AdamSedla/CoreXY-3D-printer/README.md

# CoreXY 3D printer - TrianglePrinter
Graduation project for Johannes Kepler gymnasium, school year 2022/23. Full project including documentation will be in this repository.
