AdamSedla/CoreXY-3D-printer/Documentation/CZ_documentation.pdf

# GYMNÁZIUM JANA KEPLERA

### Parléˇrova 2/118, 169 00 Praha 6

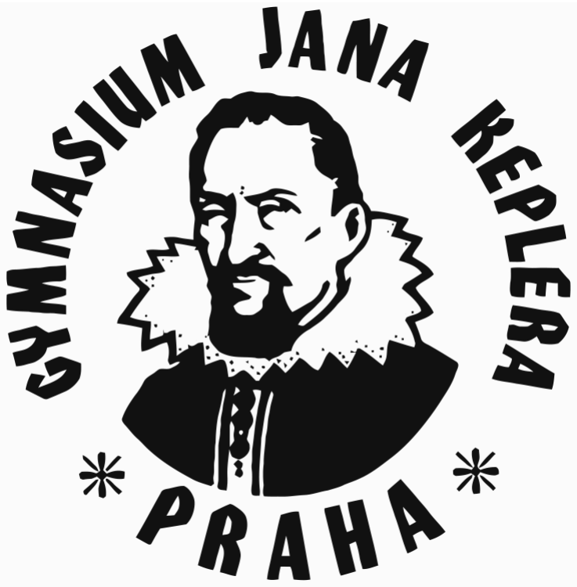
[picture p1: figure]

# Stavba CoreXY FDM 3D tiskárny

# Maturitní práce

### Autor: Adam Sedláˇcek

### Tˇrída: 4.C

### Školní rok: 2022/2023

### Pˇredmˇet: Informatika

### Vedoucí práce: Bc. Emil Miler

### Praha, 2023

# GYMNASIUM JANA KEPLERA Kabinet informatiky

# ZADÁNÍ MATURITNÍ PRÁCE

Student: | Adam Sedláˇcek
Tˇrída: | 4. C
Školní rok: | 2022/2023
Vedoucí práce: | Emil Miler
Název práce: | Stavba CoreXY FDM 3D tiskárny

## Pokyny pro vypracování:

Cílem práce je navrhnout a vytvoˇrit funkˇcní prototyp 3D FDM tiskárny urˇcené pro domácí sestavení z bˇežnˇe dostupných díl ˚u. Souˇcástí práce je pˇrehled dostupných technologií, návrh prototypu, díly k vytištˇení, seznam spojovacího materiálu, návod pro sestavení tiskárny a samotný prototyp.

## Doporuˇcená literatura:

[1] REDWOOD, Ben, Filemon SCHÖFFER a Brian GARRET. The 3D printing handbook: technologies, design and applications. Amsterdam: 3D Hubs, [2017]. ISBN 978-9082748505.

## URL repozitáˇre:

https://github.com/AdamSedla/FDM-3D-tiskarna

student | vedoucí práce

## V Praze dne 29. 9. 2022

# Prohlášení

Prohlašuji, že jsem svou práci vypracoval samostatnˇe a použil jsem pouze prameny a literaturu uvedené v seznamu bibliografických záznam ˚u. Nemám žádné námitky proti zpˇrístupˇnování této práce v souladu se zákonem ˇc. 121/2000 Sb. o právu autorském, o právech souvisejících s právem autorským a o zmˇenˇe nˇekterých zákon ˚u (autorský zákon) ve znˇení pozdˇejších pˇredpis ˚u.

V Praze dne 24. bˇrezna 2023 | Adam Sedláˇcek

# Podˇekování

Rád bych zde podˇekoval vedoucímu maturitní práce Bc. Emilu Milerovi za odborné vedení, cenné rady a ˇcas, který mi vˇenoval.

# Abstrakt

Práce se zabývá návrhem a sestavením funkˇcního prototypu FDM 3D tiskárny, urˇcené pro domácí sestavení z bˇežnˇe dostupných díl ˚u. Souˇcástí je pˇrehled dostupných technologií, návrh prototypu, seznam díl ˚u potˇrebných k úspˇešné stavbˇe tiskárny, vˇcetnˇe spojovacího materiálu, 3D modely díl ˚u k vytištˇení na 3D tiskárnˇe, návod pro sestavení tiskárny a prototyp samotný.

## Klíˇcová slova

3D tisk, FDM, XYZ, CoreXY

# Abstract

The thesis deals with the design and assembly of a functional prototype of a 3D FDM printer designed for home assembly from commonly available parts. It includes an overview of available technologies, a prototype design, a list of parts needed to successfully assemble the printer including fasteners, 3D models of the parts for printing on the 3D printer, instructions for assembling the printer and the prototype itself.

## Keywords

3D printer, FDM, XYZ, CoreXY

# Obsah

1 FDM 3D tiskárna | 2
2 Základní komponenty FDM 3D tiskárny | 5
3 návrhový proces tiskárny | 14
4 Stavba tiskárny | 23
5 Testování | 24
6 Možné vylepšení tiskárny | 25
7 Závˇer | 26
Závˇer | 26
Internetové zdroje | 27

# 1. FDM 3D tiskárna

V této ˇcásti se budu zabývat teorií FDM 3D tiskáren. Popíšu zde základy funkˇcnosti FDM 3D tiskárny a jejich typy. Pro terminologii používanou v následující ˇcásti je d ˚uležité ujasnit si osy. Osou Z je myšlena osa svislá. Osa X je ze strany na stranu. Osa Y je dopˇredu, dozadu.

# 1.1 Princip fungování

3D tiskárna na principu FDM (fused deposition modeling) Za pomocí jednotlivých souˇcástek extruderu (tiskové hlavy) vytlaˇcuje roztavený plast na pˇredem urˇcené místo na vyhˇrívané podložce. Plast je posouván podávacími koleˇcky, umístˇenými na krokovém motoru, který udává množství plastu, které je posouváno dále do extruderu. Plast je taven na samém konci tiskové hlavy v hotendu. Extrudovaný materiál je poté ochlazen pomocí pˇrídavného ventilátoru. V pˇrípadˇe Polar a XYZ principu je extruder a heatbed posouván po osách pomocí krokových motor ˚u, které jsou s posouvanou sou-ˇcástí tiskárny propojeny nejˇcastˇeji pomocí ˇremene nebo trapézové tyˇce. V pˇrípadˇe SCARA a Delta principu je pohybováno pouze extruderem a vyhˇrívaná podložka se nepohybuje. Teploty a pohyby souˇcástí jsou ˇrízeny pomocí základní desky. Ovládání funkcí základní desky je ˇrízeno pomocí pˇripojeného poˇcítaˇce nebo pomocí integrovaného displeje. Napájení elektrickou energií všech souˇcástí tiskárny je zaˇrízeno zdrojem elektrického napájení, ze kterého jde proud do základní desky, kde je požadovaná energie dodávána do jednotlivých souˇcástek.

# 1.2 Typy FDM 3D tiskáren

FDM 3D tiskárny lze rozdˇelit do 4 základních kategorií, dle principu pohybu tiskové hlavy, vzhledem ke vyhˇrívané podložce.

## 1.2.1 Cartesian

První a v souˇcasné dobˇe nejrozšíˇrenˇejší variantou je Cartesian. Jeho název je odvozen od Kartézské soustavy souˇradnic, kdy bod v prostoru je zapsán pomocí souˇradnic XYZ, které znázor ˇnují bod na osách, které jsou vzájemnˇe kolmé. Tyto tiskárny pohybují tiskovou hlavou a obdélníkovou vyhˇrívanou podložkou v osách, stejných jako jsou souˇradnice bodu v Kartézské soustavˇe. Tyto tiskárny se vyznaˇcují jednoduchostí, díky které jsou i relativnˇe levné. Tiskárna je vhodná nejen pro zaˇcáteˇcníky v 3D tisku, kteˇrí se na tomto zp ˚usobu mohou nauˇcit základy 3D tisku, ale také pro pokroˇcilé tiskaˇre, kteˇrí plnˇe využívají potenciálu tˇechto tiskáren. Také jsou pˇresné, ale oproti jiným druh ˚um 3D tiskáren nejsou tolik rychlé, vzhledem k nutnosti pohyb ˚u po osách. Kv ˚uli nutnosti pevného rámu jsou také pomˇernˇe tˇežké.

FDM 3D tiskárna

## CoreXY

CoreXY systém má hlavu pohybující se po osách X a Y. Tisková podložka je osou Z. Výhoda je vˇetší rychlost, vzhledem k lehkosti tiskové hlavy oproti podložce. Také zabírá ménˇe místa, protože nejrozmˇernˇejší souˇcást, kterou je tisková podložka, se pohybuje po ose Z. Nevýhodou je potˇreba komplexnˇejší konstrukce, která ale m ˚uže být zároveˇn i výhodou, protože nabízí vyšší pevnost rámu. Typicky je zde využita kombinace 2 motor ˚u pro pohyb po ose XY. Proto pˇri pohybu podél osy X/Y je potˇreba kooperace obou motor ˚u. Osu Z obstarává minimálnˇe jeden motor. Motory pro osu X a Y (tzv. motor A a B) m ˚uže být umístˇen na rámu. Nemusí se tedy pohybovat pˇri pohybu celou osou. To je další možnost vyšší rychlosti. Zamezení pohybu tisknutého objektu ze strany na stranu, jako je to nutné napˇríklad u CoreXZ, zvyšuje kvalitu tisku.

## H-bot

H-bot je svým principem prakticky identický s CoreXY. Jediným rozdílem je využití pouze jednoho ˇremenu pro pohon celé osy XY. Toto na jednu stranu m ˚uže zajistit mírnˇe jednodušší konstrukci. Nevýhody jsou ale menší pˇresnost a rychlost, vzhledem k nutnosti využití pouze jednoho ˇremenu.

## Crossed

Dalším principem, který je témˇeˇr identický s CoreXY je Crossed. Zde jsou pro osu X a Y využity 3 vedení na každou. Remen je veden okolo a nezasahuje do prostoru tisku. Výhodou je vyšší pˇresnost, ˇ nevýhodou vyšší váha a tím pádem i rychlost.

## CoreXZ

Zde se hlava pohybuje v ose X a Z. Tisková podložka je osou Y. Výhoda je zdánlivˇe menší prostorová nároˇcnost a menší nároky na komplexní rám. Také je zde lepší pˇrístup k tiskové hlavˇe v pˇrípadˇe servisu. Nevýhodou je potˇreba prostoru pro pohyb tiskové podložky, proto ve výsledku zabírá více prostoru. Pohybování tiskovou podložkou, která je pomˇernˇe tˇežká po ose Y, kde je vyžadován rychlejší pohyb, než na ose Z, ukazuje další nevýhodu tohoto systému. Podložku je totiž potˇreba rozpohybovat a také brzdit. Zde se projeví váha navíc, se kterou musíme hýbat. Každá osa zde m ˚uže mít vlastní motor. Na ose Z je použit typicky jeden nebo dva motory, záleží dle potˇreby. Využití separátních motor ˚u pro jednotlivé osy znamená, že kupˇríkladu motor pro osu X je potˇreba zvedat spoleˇcnˇe s celkem po ose Z. Toto je opˇet nechtˇená váha navíc. Vzhledem k pohybu tiskové plochy po relativnˇe dlouhých vzdálenostech, m ˚uže docházet ke zhoršení kvality tisknutého objektu, vzhledem k jeho otˇres ˚um.

## Belt

Osa Y je zde nekoneˇcnˇe dlouhá, díky využití pásu, na který je tisknuto typicky pod úhlem 45°. Tisková hlava se pohybuje po ose X a Z. Ve zkratce jde o CoreXZ, pouze s rozdílem pásové tiskové plochy a úhlem 45° mezi osou Z a Y.

FDM 3D tiskárna

## 1.2.2 Delta

FDM 3D tiskárny typu Delta lze také ˇradit pod Cartesian tiskárny, ale vzhledem k jejich rozdílnosti jsem se rozhodl je zaˇradit mimo. Tisková hlava je napojená na 3 spojovací tyˇce, které jsou spojeny každá s jedním posuvným bodem, který je posouván na svislých osách. Pˇri pohybu jedné osy se tisková hlava pohybuje smˇerem k posouvané ose, ale zároveˇn nahoru. Synchronizovaným pohybem všech 3 os docílíme schopnosti tisku v osách XYZ. Vyhˇrívaná podložka je kruhová a nepohyblivá Hlavní výhodou Delta tiskárny je její rychlost. Hlavní nevýhodou je prostorová nároˇcnost, vzhledem k nutnosti prostoru pro spojovací tyˇce nad nejvyšším bodem, kterého je tisková hlava dosáhnout. Tiskový prostor je omezen i co se týˇce podložky, kv ˚uli nutnosti kruhové vyhˇrívané podložky.

## 1.2.3 SCARA

Tiskárny SCARA (Selective Compliance Assembly Robot Arm) sice také používají Kartézskou soustavu souˇradnic, ale jsou opˇet natolik rozdílné, že je lze ˇradit do vlastní kategorie. Vyhˇrívaná podložka je zde opˇet kruhová a nejˇcastˇeji statická. Tisková hlava je umístˇena na jednom nebo dvou ramenech, každé má dva klouby. Ohybem tˇechto míst docílíme pohybu po celé oblasti os XY. Pohyb po ose Z m ˚uže být vykonáván bud’ pomocí pohybu celého ramena nebo pouze pomocí tiskové podložky. SCARA princip je bˇežnˇejší u robotických ramen, než u 3D tiskáren, proto se s ním nelze setkat pˇríliš ˇcasto, ve formˇe 3D tiskárny. Hlavní výhodou je rychlost, vzhledem k možnosti pohybu mimo kolmé osy. Druhou velkou výhodou je prostorová nenároˇcnost, díky které je to vhodný princip pro 3D tiskárny uzp ˚usobené pro velkoformátové tisky z industriálních materiál ˚u, jako je tˇreba beton. Tiskárna je tímto také jednoduchá na pˇrenos z jednoho místa na druhé. Hlavní nevýhodou je nepˇresnost tiskárny a nutnost vyvážení tiskového ramena, které je umístˇeno na kraji tiskové plochy.

## 1.2.4 Polar

Kategorie 3D tiskáren Polar jako jediný zp ˚usob ze seznamu nevyužívá Kartézskou soustavu sou-ˇradnic. Místo toho, jak už název napovídá, využívá Polarní zápis souˇradnic. Na rozdíl od Kartézské soustavy, je zde pro zápis umístˇení bodu v prostoru využit i úhel. Tisková hlava se zde pohybuje bud’ pouze svisle nebo se m ˚uže i naklápˇet, od stˇredu tiskové podložky po její kraj. Tisková podložka je zde kruhová a otoˇcná nebo i Pohyblivá, nahrazující pohyb tiskové hlavy od stˇredu ke kraji podložky. Hlavní výhodou je nízká cena a nenároˇcnost na konstrukci. Hlavní nevýhodou je nízká kvalita, rychlost tisku a z d ˚uvodu nerozšíˇrenosti tohoto zp ˚usobu i špatnˇe dostupná komunitní podpora.

# 2. Základní komponenty FDM 3D tiskárny

V této kapitole se budu vˇenovat všem základním komponent ˚um, ze kterých se FDM 3D tiskárna skládá.

# 2.1 Hardware

## 2.1.1 Rám

Nosný rám je možné sestavit témˇeˇr z ˇcehokoliv, co bude mít dostateˇcnou nosnost. Ale obecnˇe platí, že ˇcím pevnˇejší je rám, tím lépe bude poté tiskárna fungovat. Nejbˇežnˇeji používaným materiálem je hliník, konkrétnˇe profily z nˇej vyrobené, které mají v sobˇe zabudované drážky, do kterých je možné upevnit cokoliv, co má požadovaný tvar.

## 2.1.2 Vedení jednotlivých os pohybu

Vedení os pohybu je nosný díl os, který se skládá ze dvou ˇcástí, pevné a pohyblivé. Osa, se kterou je pohybováno je nejˇcastˇeji umístˇena na pohyblivé ˇcásti. Opaˇcné využití, kdy by se osa uchytila na ˇcást pevnou nemá žádné hlavní výhody.
U vˇetšiny FDM 3d tiskáren se m ˚užeme setkat s variantou jednoho ze tˇrí nejˇcastˇejších druh ˚u vedení. Prvním druhem je hlazená tyˇc, po které jezdí kluzné ložisko. Druhé je lineární pojezd s vozíkem. Hlazená tyˇc je nˇekolikanásobnˇe levnˇejší. Tím ale její výhody konˇcí. na druhou stranu je ménˇe pˇresná, z d ˚uvodu vˇetších v ˚uli. Také je mnohem více náchylná na špatnou údržbu. Pˇri vynechání pravidelného mazání hlazené tyˇce m ˚uže dojít k jejímu nenávratnému poškození vydˇrením drážek. Je také nároˇcnˇejší její uchycení, protože Lineární vedení má v sobˇe montážní body, díky kterým je jednoduché spojení s konstrukˇcním prvkem. U samotného vedení jde o otvory pro M3 šrouby, pomocí kterých je možné upevnˇení pˇrímo do 2020 profilu pouze pomocí odpovídajících kamen ˚u. Vozík lineárního vedení má integrované závity pro M3 šrouby. Oproti tomu hlazenou tyˇc a její ložisko je nutné upevnit pomocí dalšího konstrukˇcního prvku. Tˇretí variantou je vozík, jezdící po 2020 profilu, takzvaný V-slot. Výhodou je možnost pojezdu pˇrímo po 2020 profilu. To m ˚uže ušetˇrit mnoho místa. Nevýhodou je nutnost ˇcasté výmˇeny ložisek na vozíku. Pˇresnost m ˚uže být ze zaˇcátku podobná, jako u lineárního vedení, ale ˇcasem dochází k opotˇrebení ložisek a snížení pˇresnosti. Cenovˇe m ˚uže tento vozík pro 2020 profil vycházet velmi podobnˇe, jako lineární vedení.

## 2.1.3 Pohon jednotlivých os pohybu

FDM 3D tiskárna by nemohla fungovat bez pohybu tiskové podložky a tiskové hlavy. K zajištˇení pohybu je nutné nejenom vedení os, ale také jejich pohon. Respektive pˇrevedení otáˇcek motoru na skuteˇcný pohyb osy.
K tomu jsou využity 2 hlavní druhy pohonu, každý vhodný pro jiné využití. Pohon ˇremenem je

Základní komponenty FDM 3D tiskárny

vhodný nejˇcastˇeji pro osy X a Y, kde je potˇreba vyšší rychlost i za cenu nižší pˇresnosti. K jeho využití je nutné mít po ose umístˇené ˇremenice a vzhledem k jeho natahování pˇri dlouhodobém napnutí je vhodné mít zde umístˇenou napínací kladku nebo ˇremenici s variabilní pozicí, aby bylo dosaženo správného napnutí, protože pˇríliš povolený nebo napnutý ˇremen m ˚uže zp ˚usobovat vady tisku nebo poškození souˇcástek. Druhou variantou je trapézová tyˇc. Jde o závitovou tyˇc se závity ve tvaru rovnoramenného lichobˇežníku. Oproti ˇremenu jde o pˇresnˇejší, ale pomalejší zp ˚usob. Uchycení je jednodušší, protože zde není nutnost více konstrukˇcních prvk ˚u. Trapézová tyˇc m ˚uže držet pouze v motoru a její druhý konec je možné nechat volnˇe. Stejnˇe jako ˇremen je náchylný na špatné napnutí, trapézová tyˇc je náchylná na kˇrivost. Deformovaná tyˇc m ˚uže pˇri pˇríliš volném vedení osy, napˇríklad pˇri použití hlazené tyˇce zp ˚usobovat posun vrstvy a nedokonalost tisku.

## 2.1.4 Extruder

Extruder, neboli tisková hlava je nejd ˚uležitˇejší souˇcást celé FDM 3D tiskárny a jde o komplexní souˇcást, sestavenou z vícero souˇcástek. Skládá se z: hotendu, krokového motoru, hotend vˇetráku, ofuku výtisku.

## Hotend

Hotend samotný se vyskytuje v r ˚uzných variantách od r ˚uzných výrobc ˚u. Zde budu popisovat asi nejrozšíˇrenˇejší variantu, V6 od výrobce E3D. Jde o spojení tˇrí souˇcástek. Heatblocku, heatbreaku a heatsinku.
Heatblock je kovový kvádr, která má otvory pro výhˇrevné tˇelísko, termistor, trysku a heatbreak. Nejˇcastˇeji je vyroben z hliníku, který je lehký, levný a dobˇre vede teplo. Druhou možností, se kterou je možné se setkat je mˇed’, která je tˇežší a dražší, ale lépe vede teplo. Dobrá vodivost tepla je nutný požadavek pˇri tisku na vysoké rychlosti, protože je nutné rychle pˇrevádˇet teplo z topného tˇelíska na filament.
V heatblocku je umístˇená mimo jiné i tryska. Ta m ˚uže mít r ˚uzné pr ˚umˇery otvoru, kterým vytéká filament. Nejbˇežnˇeji používaným je pr ˚umˇer 0.4mm. Obecnˇe ale platí, že ˇcím vˇetší pr ˚umˇer, tím menší detaily a vyšší rychlost a s menším pr ˚umˇerem opaˇcnˇe. Trysky lze rozdˇelit také na základˇe materiálu, ze kterého jsou vyrobeny. Tˇechto materiál ˚u mnoho, proto zde uvedu dva nejbˇežnˇejší materiály. Nejˇcastˇejší variantou je mosaz. Tryska z mosazi je levná a dobˇre vodí teplo, ale rychle se opotˇrebuje pˇri tisku z tvrdších materiál ˚u. Tryska z nerezové oceli je ménˇe náchylná na opotˇrebení, ale zároveˇn je horším vodiˇcem tepla. Výmˇena trysky je pro mnoho lidí proces, který neradi provádˇejí, ale je to proces nutný pˇri zmˇenˇe pr ˚umˇeru trysky. Tento zdlouhavý proces se rozhodl vyˇrešit ˇceský výrobce Protoprint, se svým výrobkem Raptor. Jde o celý hotend, u kterého je možné trysku vymˇenit pomocí šroubování rukou za studena.
Souˇcástí heatblocku je také termistor, který snímá teplotu heatblocku a tuto informaci pˇredává ˇrídící desce, která na základˇe toho vyhˇrívá topné tˇelísko v heatblocku tak, aby zde byla požadovaná teplota.
Topné tˇelísko se rozlišuje na základˇe jeho velikosti a parametr ˚u. Napˇetí je urˇceno dle zdroje tak, aby tˇelísko mˇelo stejné napˇetí, jako zdroj. Výkon tˇelíska by nemˇel být pˇríliš malý, aby bylo rychle dosaženo požadované teploty a aby teplota trysky pˇríliš nekolísala, napˇríklad pˇri zapnutí ofuku tisku, které kromˇe výtisku neúmyslnˇe chladí ˇcásteˇcnˇe i trysku. Zároveˇn každá základní deska má urˇcen maximální výkon tˇelíska, který je podporován. Je nutné dbát na výbˇer kvalitního výrobce topného tˇelíska, protože pˇri koupi nekvalitního, m ˚uže být skuteˇcný výkon nižší, než je deklarovaný

Základní komponenty FDM 3D tiskárny

výrobcem a m ˚uže docházet k samovolnému ukonˇcení chodu tiskárny, z d ˚uvodu pˇríliš nízké teploty trysky.
V heatblocku je dále umístˇen heatbreak, který slouží jako uchycení heatblocku a zároveˇn vede filament. Opˇet existuje více variant, jak a z jakého materiálu m ˚uže být vyroben, kdy každý má své výhody a nevýhody. Z tohoto d ˚uvodu je výbˇer heatbreaku nutné udˇelat na základˇe využití tiskárny, pˇredevším co se používaných filament ˚u týˇce. Obecnˇe ale platí, že je nežádoucí pˇrenos tepla heatbreakem do výše umístˇeného heatsinku. Nejbˇežnˇeji používána je varianta, kdy uvnitˇr kovového tˇela heatbreaku je umístˇena PTFE trubiˇcka. Toto je vhodné pro tisk materiál ˚u s nižší teplotou tavení, jako je PLA. Pˇri nutnosti nahˇrátí trysky na vyšší teploty m ˚uže docházet k nežádoucímu tavení této trubiˇcky, protože je to také pouze plast. Již pˇri teplotˇe 202°C m ˚uže docházet k uvolˇnování malého množství nebezpeˇcných toxin ˚u. Toto množství by nemˇelo být škodlivé pro zdravého dospˇelého jedince, ale napˇríklad pro malé ptáky m ˚uže být nebezpeˇcné, protože jejich kardiovaskulární systém vstˇrebává mnohem více toxin ˚u, než ten lidský. Pˇri tisku pˇri teplotˇe 275°C již m ˚uže docházet k úmrtí tˇechto malých pták ˚u. Tisk pˇri teplotách vyšších, než 300°C s PTFE trubiˇckou by mˇel být provádˇen pouze v dobˇre vˇetraných prostorách, jinak mohou výpary ohrožovat zdraví i dospˇelých osob. Pˇri vyšší teplotˇe tisku také dochází k deformaci PTFE trubiˇcky, která ztrácí svou pevnost a m ˚uže se zdeformovat. I pˇri tisku o nižší teplotˇe by se PTFE trubiˇcka mˇela pravidelnˇe mˇenit. Možným ˇrešením je celokovový heatbreak, vyrobený z nerezu. To ˇreší problém pˇri tisku z materiál ˚u s vyšší teplotou tavení, ale pˇri tisku pˇri nižší teplotˇe m ˚uže docházet k tavení filamentu pˇríliš brzy, což m ˚uže zp ˚usobit ucpání heatbreaku. K tomu dochází, protože nerezový heatbreak je dobrý vodiˇc tepla. Problém s pˇríliš vysokou teplotní vodivostí se snaží vyˇrešit bi-metal heatbreak, který je složený z vícero kov ˚u, které jsou slisovány dohromady. Zde je redukováno riziko pˇríliš vysoké teplotní vodivosti, ale takovýto heatbreak je náchylný na kvalitu výroby a pˇri špatném zpracování pˇri výrobˇe m ˚uže ˇcasem dojít k oddˇelení tˇechto dílˇcích souˇcástí. Bi-metal heatbreak je složen z mˇedˇené ˇcásti a ocelové ˇcásti. Ocelová ˇcást, umístˇena v heatblocku, je špatný vodiˇc tepla, proto nedochází k pˇrenosu pˇríliš velkého množství tepla. Oproti tomu mˇedˇená ˇcást, umístˇená v heatsinku je dobrý vodiˇc tepla a dochází zde k dobrému rozptýlení pˇrenesené teploty do heatsinku. jako další možné ˇrešení se nabízí celokovový heatbreak, který je ale vyroben z titanu. Titan totiž má nízkou tepelnou vodivost. I zde je ale nutné vybrat kvalitního výrobce, protože m ˚uže docházet k použití ménˇe kvalitního materiálu.
Poslední souˇcástí hotendu, která je zde, aby chladila heatbreak, je heatsink. Jde o hliníkový chladiˇc, pomocí kterého je zároveˇn celý hotend pˇripevnˇen ke zbytku extruderu. Upevnˇení pomocí heatsinku je vhodné, protože heatsink pokud pracuje správnˇe by mˇel být na dotek chladný, tudíž pˇri spojení s plastovým dílem nedojde k deformaci tohoto dílu.

## Krokový motor

Aby docházelo k tisku, musí být filament podáván dále do hotendu. K tomu slouží krokový motor extruderu. M ˚uže být umístˇen pˇrímo na samotném tˇelu extruderu nebo je možné ho umístit stranou a k extruderu vést bowden pomocí PTFE trubiˇcky, která vede pˇrímo do heatbreaku. Pˇri umístˇení na extruder jde o Direct drive. Varianta, pˇri které je motor umístˇený mimo extruder se nazývá bowden. Pokud je motor umístˇený na extruderu, jde o pˇrebyteˇcnou váhu navíc, se kterou je také nutné pohybovat. Na druhou stranu motor umístˇený mimo extruder m ˚uže pˇrinášet problémy, pˇredevším pˇri tisku z flexibilních filament ˚u, protože dochází k napínání filamentu v bowdenovém vedení a je zde urˇcitá v ˚ule. Proto je nutné poˇcítat s tím, že jakmile se motor extruderu uvede do pohybu, zaˇcne se filament v hotendu pohybovat až s malým zpoždˇením.

Základní komponenty FDM 3D tiskárny

## Ventilátory extruderu

Pro svou správnou funkˇcnosti potˇrebuje extruder dva ventilátory. Prvním je axiální ventilátor, který je urˇcený k chlazení heatsinku. Druhý ventilátor je radiální a ˇríká se mu také ofuk. Je nutné, aby vzduch, který z nˇej vychází míˇril pˇrímo na trysku, aby se vytlaˇcený filament co nejdˇríve stal pevným. Pˇri nepoužití nebo nedostateˇcném ofuku m ˚uže docházet k pˇrehˇrívání výtisku, což m ˚uže mít za následek deformace.

## Volitelné souˇcásti

Existují i další souˇcásti extruderu, které zde nemusí být, ale jejich pˇrítomnost zlepšuje uživatelskou pˇrívˇetivost a jednoduchost ovládání.
Tím nejˇcastˇejším je senzor filamentu, který má za úkol urˇcit, jestli filament je stále dodáván do hotendu nebo tisková struna došla ke svému konci a tiskárna by se pohybovala, aniž by vytlaˇcovala materiál. V základu jde o velmi jednoduchý princip senzoru, který pouze zjišt’uje, jestli extruderem prochází struna. Pokroˇcilé typy tˇechto senzor ˚u jsou schopné zjistit i zaseklý filament, který se nepohybuje. Senzor musí být umístˇen pˇred motor extruderu, protože pokud by byl mezi motorem a hotendem, filament by po svém konci již nebyl podáván dále, ale senzor by ho stále zaznamenával. Dalším velmi užiteˇcným zlepšením je senzor, který je schopný na základˇe zmˇeˇrení výšky nˇekolika bod ˚u na heatbedu, urˇcit kˇrivost heatbedu a pˇrípadnˇe ho kompenzovat pohybem osy Z v pr ˚ubˇehu tisku tak, aby byla první osa vždy perfektnˇe rovná. Nejˇcastˇeji jde o senzor mechanický nebo indukˇcní. K funkci indukˇcního je potˇreba, aby mˇeˇrená podložka byla z kovu. Na druhou stranu indukˇcní senzor je pˇresnˇejší. Tento senzor m ˚uže také sloužit jako endstop osy Z, ale nedoporuˇcuje se to, protože pˇri selhání senzoru m ˚uže dojít k nenávratnému poškození tiskové podložky, nebo i dalších souˇcástí tiskárny.
V poslední dobˇe se na extruderech zaˇcíná objevovat i LED osvˇetlení. Bud’ m ˚uže být osvˇetlení namí-ˇreno pˇrímo na výtisk, aby osoba obsluhující tiskárnu mˇela pˇrehled o tom, co se dˇeje na výtisku a jestli se vše tiskne tak, jak má. Druhá varianta je signalizaˇcní RGB LED osvˇetlení, které je na viditelném místˇe a ve výsledku nemusí v ˚ubec být umístˇena na extruderu. Jde o programovatelné svˇetlo, které m ˚uže dávat ˇclovˇeku informace napˇríklad o stavu tisku, podle vyzaˇrované barvy.

## 2.1.5 Heatbed

Vyhˇrívaná podložka je souˇcást, která není nezbytná pro funkci tiskárny, ale tisk bez ní je obtížnˇejší. Díky nahˇrátí podložky na teplotu, pˇri které tisknutý plast zaˇcíná ztrácet svou pevnost zajistí, že se lépe uchytí první vrstva na tiskové podložce. I nevyhˇrívaná tisková plocha je d ˚uležitou souˇcástí, protože bez ní by tiskárna nemohla tisknout. Vyhˇrívaná m ˚uže být samotná podložka nebo m ˚uže jít o napˇríklad silikonovou plochu, která je pˇrichycena k hliníkové podložce, kterou vyhˇrívá. Vyhˇrívané podložky lze rozdˇelit podle napˇetí a velikosti. Napˇetí podložky se odvíjí od napˇetí použitého zdroje. Vˇetšinou je používaná varianta podporující 12V, 24V nebo obojí. Druhým d ˚uležitým faktorem pˇri výbˇeru tiskové podložky je její velikost. Pˇri použití pˇríliš malé podložky není možné tisknout rozmˇerné objekty a je nutné je rozdˇelit na menší souˇcásti. Výbˇer pˇríliš velké tiskové plochy vyústí ve zbyteˇcnˇe velkou spotˇrebu elektrické energie, vzhledem k velké tiskové ploše, kterou je nutno vyhˇrívat. Tuto nevýhodu se pokouší vyˇrešit novˇe uvedená 3D tiskárna Prusa XL. Tato tiskárna má vyhˇrívanou plochu rozdˇelenou na více menších segment ˚u, které je možné separátnˇe nahˇrívat. Druhou nevýhodou je vˇetší hmotnost, se kterou je nutné pohybovat. To je omezující pro

Základní komponenty FDM 3D tiskárny

rychlost tiskárny. Vˇetší tisková plocha je také nároˇcnˇejší na uchycení a pohon u typ ˚u tiskáren, které s vyhˇrívanou podložkou pohybují po ose Z. Nejbˇežnˇejším rozmˇerem, se kterým se m ˚užeme setkat u vˇetšiny FDM 3d tiskáren nabízených na trhu v dnešní dobˇe je okolo 200X200mm. V pˇrípadˇe typu Belt je tiskovou podložkou pás, který tímto vytvoˇrí možnost tisku neomezenˇe dlouhého objektu. Tiskový pás zde také m ˚uže být vyhˇrívaný.
Tisk pˇrímo na vyhˇrívanou podložku by ji mohl poškodit používáním nebo pˇredevším pˇri odstra-ˇnování hotového výtisku z plochy. Pˇri tisku pˇrímo na podložku m ˚uže také docházet ke špatnému uchycení první vrstvy. To je možné eliminovat pokrytím plochy kaptonovou páskou. Oba výše zmínˇené problémy ale ˇreší na heatbedu umístˇena dodateˇcná tisková podložka, na kterou je tištˇeno a která je ˇcasto odnímatelná. Rozšíˇrené je použití malého kusu zrcadla/skla nebo PEI tiskového plátu. Zrcadlo/sklo je výhodnˇejší z hlediska rovnosti povrchu. Nevýhodou je nemožnost ohybu, proto je nutné nanést vrstvu napˇríklad tyˇcinkového lepidla nebo speciální chemie na to urˇcené. Bez tohoto kroku je témˇeˇr nemožné odstranit výtisk z této podložky. PEI tiskový plát lze koupit v mnoha variantách. Nejˇcastˇejší je hladký a zrnitý. Nespornou výhodou je možnost ohybu, díky ˇcemuž výtisk prakticky sám odskoˇcí od podložky. Nevýhodou je nerovnost plochy. Tuto vlastnost lze odstranit pomocí mesh bed levelling, které pˇred tiskem zjistí výšku nˇekolika bod ˚u a poté v pr ˚ubˇehu tisku upravuje výšku osy Z, aby vyrovnal tuto nerovnost. Vyrovnávání probíhá v rámci setin milimetru, tudíž nedochází k deformaci výtisku.
Souˇcástí heatbedu musí být i termistor, pomocí kterého ˇrídící deska urˇcí, jestli je ještˇe nutné vytápˇet heatbed nebo již dosáhl požadované teploty. Jediný rozdíl od termistoru použitého u hotendu m ˚uže být jeho tvar, kdy zde se používá malý termistor tvaru kapky. termistor je nejˇcastˇeji pˇrichycen na spodní ˇcást heatbedu pomocí kaptonové pásky.

## 2.1.6 Krokové motory

U krokového motoru je d ˚uležitými parametry pˇri výbˇeru jeho velikost a síla.
Velikost je standardnˇe udávána v v kombinaci dvou parametr ˚u. První je šíˇrka jeho tˇela. Tato velikost je psána jako NEMA a za tím odpovídající hodnota. NEMA (National Electrical Manufacturers Association) je obchodní sdružení výrobc ˚u elektrických zaˇrízení v USA. Hodnota šíˇrky je udávána v palcích. Nejˇcastˇeji se vyskytuje varianta NEMA 17. V pˇrípadˇe potˇreby malých motor ˚u je ˇcasto využíváno NEMA 14. Naopak pˇri potˇrebˇe velké síly se využívá NEMA 23. Druhou podstatnou hodnotou je délka motoru. V pˇrípadˇe NEMA 17 je nejˇcastˇeji využívána délka 40 mm nebo 48mm. Pro malé prostory, typicky na pohonu osy Z lze také využít tzv. pancake motor. V tomto pˇrípadˇe m ˚uže být tloušt’ka i pouhých 20mm.
Druhým parametrem je kroutící moment krokového motoru. NEMA 17 motor má vˇetšinou kroutící moment v intervalu 0.2 Nm - 1 Nm. Obecnˇe platí, že ˇcím vˇetší je motor, tím vˇetší je jeho kroutící moment. Pro pohyb tˇežké souˇcástky je vhodný krokový motor s velkým kroutícím momentem, ale na druhou stranu má vyšší spotˇrebu elektrické energie. Proto je nutné vybírat krokový motor v odpovídající velikosti. Maximální možné otáˇcky motoru jsou u všech velikostí vˇetšinou stejné, ale vyšší kroutící moment je vhodný pro možnost vyšší akcelerace osy.
Krokový motor m ˚uže mít také r ˚uzný úhel kroku. Nejˇcastˇejší variantou je 0.9° a 1.8°. Krokový motor ve variantˇe 0.9° musí vykonat 400 krok ˚u na jednu otáˇcku. Varianta 1.8° polovinu. To znamená, že menší úhel znamená vyšší pˇresnost tisku, ale zároveˇn menší rychlost. Zhoršená kvalita tisku u varianty s 1.9° je dnes vyˇrešena schopností driver ˚u dˇelat tzv. micro stepping, kdy motor umí udˇelat pohyb o ménˇe, než jeden celý krok. Detailnost tisku, dosažené pˇri micro steppingu varianty 0.9° je pro bˇežného uživatele vˇetšinou zbyteˇcná a znamená pro nˇej menší rychlost tisku.

Základní komponenty FDM 3D tiskárny

## 2.1.7 Drivery

Pro ovládání krokových motor ˚u jsou na základní desce umístˇené tzv. drivery. Driver vytváˇrí impulsy pro krokové motory v požadovaných intervalech.
Drivery mohou mít i další funkce, jako napˇríklad detekce pˇretížení. Tato funkce m ˚uže být využita pro tzv. homing, kdy se tiskárna snaží najít body [0,0,0]. K tomuto se využívají fyzické spínaˇce na zaˇcátku, respektive konci každé osy. Druhou možností je využít tzv. sensorless homing, kdy se tento poˇcáteˇcní bod u každé osy nalezne pomocí nárazu pojízdné ˇcásti osy do zarážky. Driver v tu chvíli zjistí zvýšené napˇetí a tuto informaci ˇrídící deska využije pro urˇcení bodu 0. Druhou možností využití této detekce je funkce, pˇri které tiskárna detekuje náraz do pˇrekážky a pokusí se to vyˇrešit. Drivery bˇežnˇe vydávají bˇehem svého chodu zvuk. To lze vyˇrešit využitím tichých driver ˚u.
Aby nebylo nutné pohybovat krokovým motorem o celé kroky, je zde možnost micro steppingu. Pˇri té driver umí vyvolat pohyb motoru pouze o zlomek celého kroku. Micro stepping funguje na principu plynulého pˇrechodu mezi jednotlivými kroky. Driver tedy nikdy neposílá do jednoho okruhu plný proud a do druhého žádný, ale vždy je v každém okruhu odpovídající ˇcást proudu. Bˇežnˇe je možné zakoupit driver s micro steppingem 1/256.
Driver m ˚uže být napevno integrovaný do základní desky nebo m ˚uže být v základní desce mˇenitelný.

## 2.1.8 Základní deska

Základní deska je ˇrídící poˇcítaˇc, který urˇcuje a ˇrídí každý úkon tiskárny.
Hlavní vlastností, která r ˚uzné desky rozlišuje je jejich procesor. Typ procesoru je dˇelen na 8-bit a 32-bit. 32-bit základní deska je schopna vykonat 4x více výpoˇct ˚u za stejnou dobu, než 8-bit. Tiskárna je tedy nejenom rychlejší, ale také dˇelá pˇresnˇejší pohyby a je tišší. 32-bit deska má menší problémy s výpoˇcty komplexních tvar ˚u, kdy musí v g-code zpracovávat mnoho pˇríkaz ˚u za krátkou dobu. Tiskárna je díky tomu také schopna fungovat s vyššími akceleracemi. Další výhodou 32-bit je, vzhledem k zvyšující se popularitˇe tˇechto základních desek, lepší podpora. Oproti tomu 8-bit základní deska je levnˇejší a spotˇrebovává ménˇe elektrické energie. Problém s nedostatkem výpoˇcetního výkonu u 8-bit desek je v dnešní dobˇe kompenzován ve sliceru nebo firmwaru.
D ˚uležitou vlastností, na kterou bychom se pˇri výbˇeru základní desky mˇeli dívat, je jestli podporuje námi zvolené napˇetí systému. Bˇežnˇe používané je napˇetí 12V a 24V.
Drivery pro ovládání krokových motor ˚u mohou být pevnˇe integrované do desky. V takovém pˇrípadˇe není možná jeho výmˇena, ˇci zmˇena. Druhou možností jsou konektory na desce, do kterých jsou drivery zapojeny. Drivery na základní desce ovlivˇnují také poˇcet krokových motor ˚u, které lze zapojit. Vˇetšina základních desek má konektor pro jeden motor osy X, jeden pro osu Y, jeden pro motor extruder a dva konektory pro osu Z. Množství konektor ˚u je možné zvˇetšit, ale v tu chvíli je obˇema motory pohybováno stejnˇe.
Vˇetšina základních desek je stavˇena na konstrukci s jedním extruderem, dvˇema motory pro osy X a Y a maximálnˇe dvˇema motory pro osu Z. S tím souvisí nejenom výše zmiˇnované konektory pro krokové motory, ale také konektory pro ventilátory a místa pro pˇripojení termistoru a výhˇrevného tˇelíska. V pˇrípadˇe potˇreby pˇripojení více prvk ˚u, je možné vytvoˇrit spojení dvou a více základních desek, které spolu komunikují.
Nˇekteré základní desky mohou podporovat i bezdrátové pˇripojení WI-FI. Takto lze tiskárnu dálkovˇe ovládat a ˇrídit, bez nutnosti externího zaˇrízení.

Základní komponenty FDM 3D tiskárny

## 2.1.9 Ovládání

Možnosti ovládání tiskárny se dˇelí primárnˇe na ovládání pˇrímo na tiskárnˇe a na vzdálenou správu tiskárny. K ovládání tiskárny pˇrímo se využivá displej, který m ˚uže a nemusí být dotykový. V displeji bývá ˇcasto integrovaná i ˇcteˇcka SD karet. Na tuto SD kartu je nahrán G-code s tiskovým souborem. Druhou možností je vzdálený pˇrístup. To lze uskuteˇcnit bud’ pˇrímo pˇres základní desku, pokud má možnost pˇripojení k jinému zaˇrízení. To lze provést bud’ pˇrímo pˇres USB kabel nebo pomocí pˇripojení k síti. V tomto pˇrípadˇe je tisk zadáván pˇrímo pomocí poˇcítaˇce. Výhodou je, že není potˇreba externí pˇrenosné úložištˇe. Nevýhodou je nutnost stálého pˇripojení tiskárny k poˇcítaˇci. Tuto nevýhodu lze vyˇrešit pomocí externího malého poˇcítaˇce typu RaspBerry Pi. Takovéto zaˇrízení je pˇripojeno k tiskárnˇe permanentnˇe a dovoluje její vzdálenou správu. U firmwaru Klipper je toto ovládání pˇrímo integrované, protože pro funkci Klipperu je nutný externí poˇcítaˇc typu RPi. Octoprint je možné využít i pro Klipper, ale je to nevhodné, protože Octoprint je vytvoˇren a optimalizován pro Marlin. Nejpoužívanˇejšími systémy pro práci s Klipperem jsou v dnešní dobˇe Mainsail a Fluidd. Nevýhodou takto permanentnˇe pˇripojeného zaˇrízení je jeho vyšší cena, která navíc v dnešních dnech je kv ˚uli nedostatku ˇcip ˚u i nˇekolikanásobnˇe vyšší, než byla pˇred touto situací. V pˇrípadˇe používání vícero 3D tiskáren, je možné tento poˇcítaˇc využít pro ovládání více tiskáren. Tato možnost funguje v systému Klipper i Marlin.

## 2.1.10 Zdroj

Výbˇer správného zdroje je závislý na dvou podstatných parametrech. jeho napˇetí a výkon.
Zdroje jsou bˇežnˇe dostupné ve variantˇe 12V nebo 24V. Napˇetí zdroje by mˇelo souhlasit s napˇetím podporovaným základní deskou, napˇetím heatbedu, topnému tˇelísku hotendu a ventilátoru. V pˇrípadˇe nutnosti napájení souˇcástky jiným napˇetím je možné využít konvertor. Nicménˇe jde o další souˇcástku, kde dochází ke ztrátám energie a m ˚uže dojít k poruše, proto je nejlepší se jim vyhnout. Napˇríklad pro napájení RaspBerry Pi je nutné napájení o napˇetí 5V. V takovouto chvíli je tedy nutné použít konvertor. Výhoda 12V zdroje je nižší cena. Oproti tomu výhodou 24V zdroje je pˇredevším vyšší výkon, díky platnosti Ohmova zákona. Jeho znˇení je I =

U
R

. I je zde elektrický proud (jednotka A). U je zde elektrické napˇetí (jednotka V). R je zde elektrický odpor (jednotka Ω). Zkrácenˇe znamená, že pokud je ve stejném vodiˇci vyšší elektrické napˇetí, je i vyšší elektrický proud. Tím pádem pˇri použití 24V m ˚uže stejnˇe velkými kabely procházet vˇetší proud. To znamená, že kupˇríkladu stejnˇe velké topné tˇelísko je schopné vyššího výkonu. Druhou výhodou je, že lze použít menší pr ˚umˇer vodiˇc ˚u, než by byl potˇreba u 24V. Díky tomu menšímu pr ˚umˇeru je ve vodiˇcích menší odpor a dochází k menším ztrátám energie. Pˇri použití stejných vodiˇc ˚u, jako je nutné u 12V varianty zde dochází k menšímu zahˇrívání a je tedy vyšší úroveˇn bezpeˇcnosti. U 24V systému také pracují krokové motory rychleji, než u 12V.
Druhou hodnotou, na kterou je tˇreba se dívat pˇri výbˇeru zdroje, je výkon. Pˇri použití pˇríliš slabého m ˚uže docházet k nedostatku elektrické energie, což se m ˚uže projevovat výpadky tiskárny. Pˇri použití pˇríliš silného zdroje je spotˇreba elektrické energie zbyteˇcnˇe vysoká. Pˇribližný potˇrebný výkon lze spoˇcítat. Nejprve je potˇreba seˇcíst odbˇer elektrické energie všech zaˇrízení, které bude zdroj napájet. Typicky jde o heatbed, topné tˇelísko hotendu, základní deska, krokové motory a pˇrípadný druhý ˇrídící poˇcítaˇc. Odbˇer ventilátor ˚u je zanedbatelný. Vzhledem k tomu, že zdroj funguje nejlépe pˇri vytížení pˇribližnˇe 70%, dopoˇcítáme požadovaný pˇribližný výkon zdroje. Nakonec zbývá si vybrat z možností, které jsou bˇežnˇe dostupné na trhu. Obecnˇe je lepší vybírat ze zavedených a ovˇe-ˇrených výrobc ˚u. Zdroj je poté sice dražší, ale mˇel by vydržet déle. Typickým pˇríkladem zavedeného výrobce je Meanwell.

Základní komponenty FDM 3D tiskárny

# 2.2 Firmware

Firmware je software nahraný na základní desku tiskárny, pomocí které je celá tiskárna ovládána. Volnˇe dostupných možností Firmwaru je dnes celá ˇrada. Zde se ale budu vˇenovat dvˇema nejznámˇejším, Marlinu a Klipperu. Jejich nespornou výhodou je velká komunita. Tudíž v pˇrípadˇe jakéhokoliv problému není problém se zeptat na jednom z mnoha diskuzních míst.

## 2.2.1 Marlin

V dnešní dobˇe je nejrozšíˇrenˇejším firmwarem Marlin. Jde o systém vydaný k opensource použití v roce 2011 a je dodnes vyvíjen. Je napsán v jazyce C++ a bˇeží pˇrímo na základní desce. Je jednodušší na konfiguraci, než Klipper. Na druhou stranu pˇri každé úpravˇe nastavení je tˇreba systém znovu kompilovat a nahrát na základní desku. Oproti Klipperu je pomalejší, protože veškeré výpoˇcty a práce musí probíhat na použité základní desce.
Ke své funkci potˇrebuje pˇripojení k poˇcítaˇci nebo displej. Pomocí tohoto pˇripojeného zaˇrízení je tiskárna ovládána a jsou jí zadávány soubory k tisku. Je zde podpora 8-bit i 32-bit základních desek. Bývá také ˇcasto využíván i pro jiné domácí CNC stroje, jako napˇríklad obrábˇecí stroje. Výhodou Marlinu je jeho podpora jednoduchých, ale úˇcinných pˇríkaz ˚u v G-codu. Jde o krátký pˇríkaz, který pˇri naˇctení vyvolá požadovanou akci. Napˇríklad pˇríkaz G29 vyvolá mesh bed levelling. Marlin je vhodný pro zaˇcáteˇcníky, kv ˚uli nenároˇcnosti nastavení. Zároveˇn má nižší náklady na hardware, protože systém m ˚uže bˇežet na základní desce. Pˇri požadavku na dálkovou správu tiskárny, lze využít systém Octoprint, mimo možnost dálkového ovládání tiskárny dále dovoluje napˇríklad živé sledování tisku pomocí kamery, automatická detekce chyby v tisku pomocí kamery nebo ovládání pomocí mobilní aplikace. Pˇri využití Octoprintu je nutné pˇripojení tiskárny k poˇcítaˇci typu Raspberry Pi. V takovém pˇrípadˇe se ale již m ˚uže více vyplatit využít jako firmware systém Klipper.

## 2.2.2 Klipper

Klipper je mladší systém, vydaný v roce 2016 k opensource použití a stále vycházejí nové verze. Samotný firmware pro tiskárnu je napsaný v C. Software, který musí bˇežet na pˇripojeném RPi, zvaný Klippy je napsaný v Pythonu. Klipper byl p ˚uvodnˇe vyvíjen pro funkci s Octoprintem. Pozdˇeji pro nˇej vznikly systémy nahrazující Octoprint, pˇrímo pro Klipper optimalizované. Nejpoužívanˇejšími jsou Mainsail a Fluidd. Zámˇerem vývoje jiného firmwaru pro Octoprint bylo vytvoˇrit systém, který by výpoˇcty provádˇené na základní desce pˇresunul na externí poˇcítaˇc a základní deska by zde sloužila pouze pro práci s hardwarem tiskárny. Z tohoto d ˚uvodu má Klipper dostupné funkce stejné, jako jsou dostupné v Octoprintu. Díky výše zmiˇnovanému externímu poˇcítaˇci pro výpoˇcty je tiskárna se systémem Klipper rychlejší a zároveˇn pˇresnˇejší pˇri tisku, díky vyššímu poˇctu krok ˚u krokového motoru za vteˇrinu. Pˇri správném nastavení a naladˇení tiskárny m ˚uže být tisk i nˇekolikanásobnˇe rychlejší. Tiskárna je ovládána bud’ pˇres pˇripojený displej nebo pˇres rozhraní, spustitelné ve webovém prohlížeˇci, které bˇeží na pˇripojeném RPi. Pˇres toto rozhraní lze také provádˇet rychlé zmˇeny v nastavení tiskárny. Po provedení zmˇeny staˇcí konfiguraˇcní soubor uložit a tiskárnu restartovat. Jde o nespornou výhodu oproti Marlinu, protože u nˇej je potˇreba znovu kompilovat celý firmware. Na druhou stranu prvotní nastavení firmwaru je u Klipperu nároˇcné, pˇredevším protože je nutné správnˇe nastavit Základní desku, i RPi. Klipper podporuje 8-bit i 32-bit základní desky. Pˇri dostateˇcném výpoˇcetním výkonu RPi je možné zapojit více tiskáren na jeden poˇcítaˇc. Klipper postrádá možnost specializovaných pˇríkaz ˚u v G-codu, kterou nabízí Marlin. Jako náhradu toho

Základní komponenty FDM 3D tiskárny

zde lze tvoˇrit makra. Jde o definovaný postup práce tiskárny, ke které dojde pˇri spuštˇení daného makra. Velkou výhodou systému Klipper je možnost tzv. input shaping. Pˇri správném nastavení této funkce, tiskárna na základˇe informací z akcelerometru umístˇeného na extruderu je schopna vyrušit nežádoucí vibrace tiskárny. Takovéto vibrace by mˇely negativní dopad na kvalitu tisku.

# 3. návrhový proces tiskárny

Návrh celé tiskárny trval pˇribližnˇe 3 mˇesíce. Zde budu popisovat tento proces a vysvˇetlím, jaké souˇcástky a firmware jsem se rozhodl využít a proˇc. Jako inspiraci a pomoc napˇríklad pˇri zapojování elektroniky mi posloužila tiskárna Voron V0.1, pˇredevším díky tomu, že má koncepci, kterou jsem se rozhodl stavˇet. Má také velmi kvalitnˇe zpracovaný návod, který mi mohl být nápomocný v pˇrípadˇe potˇreby.

# 3.1 Požadavky na navrhovanou tiskárnu

- Bˇežnˇe dosažitelná rychlost vyšší než 150mm/s, bez redukce kvality tisku
- Možnost dálkové správy tiskárny
- Pˇresný tisk
- Pevný rám odolný pˇri pˇrevozu tiskárny
- Kompaktní velikost
- Osvˇetlení tiskové plochy
- Dobˇre pˇrístupná elektronika s možností organizace kabel ˚u

# 3.2 Výbˇer koncepce FDM 3D tiskárny

První vˇec, kterou bylo nutné urˇcit byla koncepce tiskárny. Rozhodl jsem se pro CoreXY, protože splˇnuje požadavky, které jsem si stanovil. Díky pohybu tiskové podložky po ose Z je tiskárna kompaktnˇejší, než napˇríklad u principu CoreXZ, který využívá má dosavadní tiskárna, Prusa i3 MK2.5S. Oproti CoreXZ má CoreXY i robustnˇejší rám. Díky Stabilnímu obrysu tiskové plochy v ose Y, jsem si mohl dovolit dát elektroniku ze zadní strany tiskárny. To mi dovoluje mít ji dobˇre pˇrístupnou, v pˇrípadˇe nutnosti oprav.

návrhový proces tiskárny

# 3.3 výbˇer vhodných souˇcástí

Výbˇer správných souˇcástí pro 3D tiskárnu je klíˇcový pro dobˇre fungující celek. Výbˇerem komponent ˚u jsem strávil mnoho hodin, pˇredevším snahou vyznat se ve všech možný variantách. Nápomocny mi v tu chvíli byly internetové diskuze, kde sice bylo možné nalézt argumenty pro každou variantu, ale dalo mi to pˇribližný pˇrehled o výhodách a nevýhodách jednotlivých možností. Aby tiskárna fungovala bez nutnosti ˇcastých servisních zásah ˚u, považoval jsem za d ˚uležité vybrat i kvalitního výrobce. K tomu jsem opˇet využil internetové diskuze, kde jsem se doˇcetl o r ˚uzných zkušenostech s výrobci. Souˇcástky jsem vybíral i na základˇe ceny, aby byl co nejlepší pomˇer ceny a kvality.

## 3.3.1 Hardware

## Rám

Zvolená varianta: Hliníkové profily 2020

Profily 2020 jsem vybral, kv ˚uli jejich malé velikosti, ale zároveˇn dobré pevnosti. Pro tiskárnu mých rozmˇer ˚u jsou plnˇe dostaˇcující. Vˇetší profily, napˇríklad 3030 by již mohly být zbyteˇcnˇe tˇežké. Menší profily, napˇríklad 1515 mi pˇrišly až pˇríliš malé.

## Vedení jednotlivých os pohybu

Zvolená varianta: Lineární vedení MGN12H 250mm

Lineární vedení má oproti hlazeným tyˇcím mnoho výhod a jedinou nevýhodou je vyšší cena, za kterou ale ˇclovˇek získá lepší produkt. Z tohoto d ˚uvodu jsem se rozhodl lineární vedení využít. Nabízí dobrou pˇresnost a nemá problém s vyšší rychlostí. Jakýmsi bonusem je snadnˇejší pˇripevnˇení k rámu, tedy profil ˚um 2020. Typ MGN12H jsem vybral, pˇredevším, protože mnou vybraný extruder je stavˇený na tento typ, ale zároveˇn jde o pro mé využití ideální velikost. P ˚uvodnˇe jsem zamýšlel použití délky 200mm. Ale kv ˚uli nutnosti použít podložku 180 mm X 180mm místo p ˚uvodnˇe zamýšlené 150 mm X 150 mm jsem byl nucen využít variantu 250mm. Chtˇel jsem, aby tisková hlava byla schopna tisku po celé podložce, tudíž minimální velikost je 180mm. Vozík lineárního vedení MGN12H má na délku 45.4mm, což nám dává nutnost délky vedení minimálnˇe 225.4mm. Nejbližší bˇežnˇe prodávaná délka je použitá 250mm. Prostor okolo tiskové podložky, kterého je tisková hlava schopna dosáhnout je možné do budoucna využít, napˇríklad automatickým oˇcištˇením trysky ocelovým kartáˇcem pˇred tiskem.

návrhový proces tiskárny

## Pohon jednotlivých os pohybu

Zvolená varianta: Remen a trapézová tyˇc ˇ

Pro pohon osy XY jsem využil ˇremen, protože v porovnání s trapézovou tyˇcí jde o mnohem rychlejší variantu a ztráta pˇresnosti je ve výsledku témˇeˇr zanedbatelná. Nutnost dobrého napnutí ˇremenu jsem vyˇrešil integrovaným napínákem.
Pro osu Z jsem využil trapézovou tyˇc, protože je jednodušší na implementaci a má vhodnˇejší vlastnosti pro osu Z.

## Extruder

Zvolená varianta: Voron StealthBurner

Návrh nového extruderu je nároˇcný a dlouhý proces. Z tohoto d ˚uvodu jsem se souhlasem vedoucího své práce využil již hotový extruder. Ze všech možný variant mˇe nejvíce zaujal OpenSource projekt Voron StealthBurner, nejdˇríve svým vzhledem. Vzhledem k tomu, že vˇetšina extruder ˚u je stavˇena bez ohledu na vzhled, tento mˇe zaujal. Po bližším zkoumání jsem zjistil, že i splˇnuje mé požadavky. Je zamýšlený na lineární vedení, které jsem chtˇel využít. Také má možnost pˇripojení 3 RGB led svˇetel. Jedno je z pˇrední strany, které slouží jako signalizaˇcní. Další dvˇe jsou poté namíˇrené pˇrímo na extruder, jako osvˇetlení pracovní plochy, které jsem u pˇredchozí tiskárny postrádal. Výhodou je také podpora hotendu typu E3D Revo, který jsem p ˚uvodnˇe zamýšlel použít. Zprvu jsem se obával, že zvolený extruder je pˇríliš velký. Proto bylo druhou možností použít Voron Mini AfterBurner. Nejen z d ˚uvodu absence osvˇetlení tiskové plochy jsem nakonec rozhodl o StealthBurneru.

## Hotend

Zvolená varianta: E3D V6

P ˚uvodnˇe jsem chtˇel využít novˇe vzniklou variantu hotendu, která má trysky vymˇenitelné rukou az studena. Jde ale o nˇekolikanásobnˇe dražší variantu nejen na poˇrízení, ale i samotné trysky jsou dražší. Bohužel je zde také omezený maximální pr ˚utok filamentu, tudíž je hotend nevhodný pro vysokorychlostní tisky. Volba nakonec padla na E3D V6. Jde o bˇežnˇe používaný typ hotendu, který má bˇežnˇe dostupné i neoriginální díly.

## Heatblock

Zvolená varianta: Hliníkový

Hliníkový heatblock jsem využil, protože jde o dostupnou a dostaˇcující variantu. V pˇrípadˇe nutnosti není problém v budoucnu vymˇenit heatblock za mˇedˇený.

návrhový proces tiskárny

## Heatbreak

Zvolená varianta: Titanový

Výbˇer heatbreaku byl velmi nároˇcný. Pˇredevším, protože vˇetšinou využívám materiál PLA. V takovém pˇrípadˇe je nejlepší volbou heatbreak, s PTFE trubiˇckou. Rád bych ale byl schopen využívat i pokroˇcilejší materiály, jako je napˇríklad polykarbonát. K tomuto je PTFE trubiˇcka nevhodná, až nebezpeˇcná, a bylo by ideální využít celokovový heatbreak. Nabízel se proto bud’ bi-metal nebo Titanový. U bi-metal heatbreaku jsem se bál kvality zpracování. Proto jsem nakonec koupil kvalitní titanový heatbreak.

## Heatsink

Zvolená varianta: Hliníkový

Heatsink z hliníku je stejnˇe jako u heatblocku dostupná a dostaˇcující varianta.

## Topné tˇelísko

Zvolená varianta: 24V 40W

Napˇetí 24V bylo je dané zdrojem. Výkon 40W je dostateˇcnˇe výkonný, aby tryska rychle dosáhla požadované teploty a zároveˇn základní deska nebyla pˇretˇežována. V pˇrípadˇe potˇreby je možné tˇelísko vymˇenit za 50W variantu.

## Termistor

Zvolená varianta: NTC100K

Jde o bˇežnˇe používaný termistor, který má požadované rozmˇery.

## Ventilátory

Zvolená varianta: Radiální 5015 24V a Axiální 4010 24V

Typy ventilátor ˚u jsou dány extruderem a napˇetí zdrojem, tudíž zde jsem nic nemusel vybírat

návrhový proces tiskárny

## Krokový motor extruderu

Zvolená varianta: LDO-36STH20

Varianta krokového motoru je pevnˇe dána typem extruderu. Jedinou vˇecí, kterou jsem musel rozhodnout byl výrobce. Mˇel jsem na výbˇer z neznámého výrobce, který nabízel motor za cca 300 Kˇc nebo kvalitního a provˇeˇreného výrobce LDO, který ho nabízel na 600 Kˇc. Nakonec jsem se rozhodl si pˇriplatit a koupit ten kvalitnˇejší, protože jde o d ˚uležitou souˇcástku, která by v pˇrípadˇe špatné výrobní kvality mohla kazit výtisky.

## Volitelné dopl ˇnky extruderu

Zvolené možnosti: Indukˇcní mesh bed levelling senzor, senzor filamentu, Osvˇetlení extruderu

Aby byla tiskárna schopna dobˇre vytisknout první vrstvu, je vhodným nástrojem k tomuto indukˇcní senzor vzdálenosti. Na tiskárnˇe je nyní namontován senzor typu SN-04N. Senzor jsem zatím nezprovoznil, z d ˚uvodu nedostatku ˇcasu.
Dalším užiteˇcným doplˇnkem je senzor filamentu, aby tiskárna byla schopna rozpoznat, když dojde ke konci struny. Voron StealthBurner nemá integrovaný senzor, ale na Printables.com jsem nalezl upravenou ˇcást tˇela extruderu, s prostorem pro jednoduchý spínaˇc. Druhou možností bylo vést filament pˇres externí senzor filamentu, který by sice fungoval lépe, ale omezovalo by to pohyb filamentu pˇri tisku.
Zvolený extruder má již v základu integrované RGB LED osvˇetlení, tudíž je to další volitelná sou-ˇcást extruderu, kterou jsem se rozhodl využít. Bohužel v dobˇe stavby tiskárny nebyly potˇrebné LED diody WS2812B dostupné, proto k jejich implementaci prozatím nedošlo.

## Heatbed

Zvolená varianta: 180mm x 180mm 24v

Napˇetí vyhˇrívané podložky je opˇet dáno zdrojem, tudíž jsem musel vybrat pouze velikost. P ˚uvodnˇe jsem chtˇel 150mm X 150mm, protože je dostateˇcnˇe velká, ale zároveˇn není zbyteˇcnˇe veliká. Bohužel ale se tato velikost nenabízí ve 24V variantˇe. 120mm X 120mm varianta je pro mé využití pˇríliš malá, protože jsem se rozhodl pro 180mm X 180mm. Pokud bych v budoucnu došel ke zjištˇení, že je pˇríliš malá, je zde dostatek prostoru pro zakomponování podložky o velikosti až cca 300mm X 300mm. V takovém pˇrípadˇe by ale již byla nutná lehká zmˇena konstrukce a pˇridání dalších upevnˇení osy Z.

## Krokové motory

Zvolená varianta: 17HS8401S 1.8°

Vybrané motory jsou velikosti NEMA 17, 48mm. Jde o ideální velikost a tím pádem i sílu motor ˚u. Variantu 1.8° jsem vybral, protože zvýšení pˇresnosti, ke které by došlo s použitím varianty 0.9°, je témˇeˇr neznatelné. Oproti tomu rychlost motor ˚u by pravdˇepodobnˇe byla znatelnˇe snížena.

návrhový proces tiskárny

## Drivery

Zvolená varianta: TMC2209 UART

Mnou vybraná základní deska má již integrované drivery, tudíž zde jsem nemohl vybírat. Ale vlastnosti tˇechto integrovaných driver ˚u byl jeden z d ˚uvod ˚u, proˇc jsem tento model základní desky zvolil. Jedním z nich je detailní microstepping 1/256, díky ˇcemuž je tiskárna pˇresná a výtisky kvalitní. Další je nízká hluˇcnost, protože jde o tiché drivery. V neposlední ˇradˇe byla pro mˇe také d ˚uležitá možnost sensorless homing. Díky této vlastnosti, kdy drivery jsou schopny poznat zvýšený odpor v motoru, je možné zprovoznit také funkci detekce nárazu.

## Základní deska

Zvolená varianta: BTT SKR MINI E3 V3.0

Tuto desku jsem vybral, protože splˇnuje mé požadavky. Jde o rychlou tiskárnu s integrovanými drivery, které mají vlastnosti, které jsem požadoval (viz výše). Také podporuje pˇripojení displeje a RGB osvˇetlení pro signalizaci nebo osvˇetlení tiskové plochy. V pˇrípadˇe potˇreby je možné pˇripojit k ní externí senzor filamentu od stejného výrobce, který je schopen odhalit nejenom konec filamentu, ale i zaseklý filament.

## Ovládání

Zvolená varianta: RaspBerry Pi4B 1GB RAM

Tiskárna je ovládána pˇripojeným RaspBerry Pi4B. Jde o nutnost, vzhledem k mému výbˇeru firmwaru. Bohužel v souˇcasné dobˇe kv ˚uli celosvˇetovému nedostatku ˇcip ˚u je cena RPi i nˇekolikanásobnˇe vyšší, než pˇred touto situací. Proto jsem zakoupil témˇeˇr nepoužité RPi na portálu Aukro.cz. P ˚uvodnˇe jsem chtˇel variantu s více RAM pamˇetí, ale objevila se nabídka na toto RPi za pˇrimˇeˇrenou cenu, proto jsem po krátkém pr ˚uzkumu, jestli bude 1GB RAM dostaˇcující, RPi zakoupil. Varianta s 1GB RAM je dostaˇcující a v pˇrípadˇe potˇreby je možné pˇripojit i další tiskárny.

návrhový proces tiskárny

## Zdroj

Zvolená varianta: MeanWell LRS-350-24

Výrobce zdroje jsem zvolil MeanWell, protože by mˇelo jít o kvalitního výrobce zdroj ˚u.
Výbˇer 24V varianty jsem udˇelal, protože nabízí možnost vyššího výkonu, pˇri stejnˇe velkých komponentech, napˇríklad u topného tˇelíska.
Potˇrebný výkon zdroje lze spoˇcítat. Pˇri vypsání si odbˇeru elektrické energie všech zaˇrízení, si lze odvodit, jaký maximální výkon m ˚uže být potˇrebný. I pˇri využití lehce slabšího zdroje by nemˇel nastat problém napˇríklad se samovolným vypínáním tiskárny. To nastává až pˇri silnˇe pˇretíženém zdroji. Ideální je využít takový zdroj, aby pˇri bˇežném využití pracoval pˇribližnˇe na 70% výkonu. To není problém, protože plné zatížení nastává pouze v pˇrípadˇe, že by heatbed a hotend byly plnˇe vyhˇrívány, RPi a základní deska by pracovaly na plný výkon a zároveˇn všechny krokové motory plnˇe využívaly svou sílu. Ve skuteˇcném využití se vˇetšinou RPi a základní deska nikdy nedostanou do režimu, kdy by pracovaly na plné zatížení. I v pˇrípadˇe, že by takováto situace nastala, jejich odbˇer elektrické energie je stejnˇe jako odbˇer ventilátor ˚u, oproti ostatním komponent ˚um zanedbatelný. Pˇri spuštˇení tiskárny se nejdˇríve tiskárna nahˇreje a až poté pohybuje krokovými motory na tisk, bˇehem kterého už jen krátce a lehce pˇridává energii na výhˇrev podložky. Odbˇer elektrické energie krokovými motory také není tak velký, jako m ˚uže být jejich maximální, protože je softwarovˇe omezen jejich výkon, aby nedocházelo k pˇrehˇrívání. Tyto chvíle, bˇehem kterých je odbˇer proudu nejvˇetší, se tedy vˇetšinou nedˇejí zároveˇn. Pˇri Vyhˇrívání podložky a hotendu je zatížení zdroje pˇribližnˇe 65%. K tomu ale musíme zapoˇcítat i odbˇer energie základní deskou a RPi. Ve výsledku se tedy tiskárna v takovouto chvíli dostane pˇribližnˇe právˇe na chtˇených 70% zatížení. Pˇri tisku, jen samotné motory mohou odebírat 25% celkového výkonu zdroje. Pˇri zapoˇctení nutnosti slabého vytápˇení heatbedu a hotendu, by zatížení zdroje mˇelo být na menší hodnotˇe, než již zmiˇnovaných 70%. Nakonec jsem vybral variantu s výkonem 350W.

### Pˇrehled jednotlivých souˇcástek a jejich elektrický výkon

Heatbed | 190W
Hotend | 40W
Krokový motor XYZ | 24W
Krokový motor extruderu | 19,2W
Základní deska | cca 15W
RaspBerry Pi | 15W
Ventilátor (radiální) | 3,9W
Ventilátor (axiální) | 2,4W
Celkem | 357,5W

### poznámka k pˇrehledu:

Výkon krokového motoru XYZ je uveden pro jeden motor po softwarovém omezení.
Výkon BTT SKR mini E3 v3.0 se mi bohužel nepodaˇrilo dohledat, budu tedy poˇcítat s tím, že elektrický výkon je stejný jako u RPi.

návrhový proces tiskárny

## 3.3.2 Software

## Firmware

Zvolená varianta: Klipper

Pro Klipper jako firmware použitý na tiskárnˇe jsem se rozhodl, protože jde o pro mˇe nový systém, který jsem dˇríve neznal a hned z poˇcátku mi pˇripadal zajímavý a chtˇel jsem ho vyzkoušet. Má mnoho výhod a jedinou nevýhodou, kromˇe obtížnˇejšího prvotního nastavení nutnost pˇripojení RPi. Vzhledem k tomu, že jsem plánoval integrovat tiskárnu do systému Octoprint, neznamenalo to pro mˇe problém. Klipper splˇnuje mé podmínky na rychlou a pˇresnou tiskárnu, k jejímuž ovládání není nutná SD karta.

## Ovládací prostˇredí

Zvolená varianta: Mainsail

Ze systém ˚u, pro ovládání tiskárny s Klipperem jsou nejpoužívanˇejšími Mainsail a Fluidd. Nakonec jsem se rozhodl pro Mainsail, protože mi byl doporuˇcen spolužákem, který ho již využívá.

návrhový proces tiskárny

# 3.4 Tvorba 3D model ˚u tištˇených díl ˚u

Zakoupené díly je nutné nˇejakým zp ˚usobem upevnit k sobˇe nebo na rám. Jsou dvˇe varianty, jak je to možné provést. První je si zakoupit spojovací materiál urˇcený pro tento úˇcel. Pro profily 2020 je takovéhoto pˇríslušenství mnoho. Výhodou je, že požadovaný díl mám rychle dostupný. Na druhou stranu je poté stavba tiskárna finanˇcnˇe nároˇcnˇejší.
Druhou možností je si požadované díly vymodelovat a vytisknout na jiné 3D tiskárnˇe. Takovouto praxi dˇelá napˇríklad velmi rozšíˇrený ˇceský výrobce 3D tiskáren, Prusa. Velkou výhodou je, že soubory mohou vzniknout pˇrímo na míru a v pˇrípadˇe nutnosti zmˇeny, není problém 3D model upravit. Další velkou výhodou, napˇríklad u zmínˇeného výrobce Prusa, je možnost vytisknout si díl, v pˇrípadˇe jeho poškození a nutnosti náhrady. Problém s tímto pˇrístupem k výrobˇe vlastních díl ˚u, je nutnost mít 3D model souˇcástí. Pokud není žádný vhodný volnˇe dostupný, je nutné si ho vymodelovat, což je ˇcasovˇe velmi nároˇcné. Já jsem se rozhodl pro vymodelování všech souˇcástí, kromˇe Extruderu. Vše bylo modelováno v programu Fusion 360, protože s ním pracuji již dlouho a znám i jeho pokroˇcilé funkce, které jsem bˇehem navrhování musel mnohokrát použít.
Nejprve jsem zaˇcal vymodelováním všech zakoupených souˇcástí, aby byl schopen je vložit do návrhu tiskárny a pracovat s jejich rozmˇery. Následoval nosný rám heatbedu, protože heatbed a extruder jsou jedinými pevnými body, na základˇe kterých jsem mohl vytváˇret tiskárnu. Pokraˇcoval jsem Osou Z. Tím je myšleno vedení i pohon. Lineární vedení jsem umístil na vertikální profily 2020, které jsem umístil na horizontální profily. Tyto horizontální profily zároveˇn slouží, jako nosné body pro umístˇení elektroniky. Kv ˚uli druhému pevnému elementu, extruderu, jsem si poté do modelovacího prostˇredí vložil volnˇe dostupný model mnou zvoleného extruderu. Vytvoˇril jsem si nosník osy X, na které se extruder pohybuje a tento nosník umístil na vedení osy Y. Pokraˇcoval jsem napínacími zaˇrízeními v pˇrední ˇcásti tiskárny, které zároveˇn slouží jako nástroj pro správné umístˇení lineárního vedení osy Y, aby bylo pˇripevnˇené tak, aby na sebe jednotlivé osy byly kolmé. V zadní ˇcásti tiskárny jsem dále vytvoˇril nosník motor ˚u A a B. Nyní jsem mohl vytvoˇrit celou konstrukci rámu. Do zadní ˇcásti jsem poté pˇridal d ˚uležité prvky elektroniky, jako napˇríklad nosník zásuvky, RPi a základní desky nebo ochranné mˇrížky z pˇrední a boˇcní strany. Dále jsem vymodeloval podstavné nohy, které vytváˇrí prostor, nutný pro motor osy Z. Zároveˇn tlumí vibrace, které by se z tiskárny pˇrenášely do napˇríklad stolu, na kterém by tiskárna byla umístˇena. Toto by mohlo zp ˚usobovat pˇríliš vysokou úroveˇn hluˇcnosti tiskárny. Nakonec jsem vytvoˇril držák filamentu, umístˇený na horní ˇcásti rámu tiskárny.

# 4. Stavba tiskárny

Stavba probíhala podle návodu, který je pˇriložen v mém repozitáˇri. Bˇehem stavby jsem nenarazil na žádné vˇetší komplikace. Pˇri kompletování rámu se nejdˇríve zdálo, že je celý kˇrivý a nepevný. Celá konstrukce se ale postupnˇe s pˇridávanými profily zpevˇnovala. Na konci stavby rámu se vše ukázalo být v poˇrádku. Kabely vedoucí z extruderu jsem musel prodlužovat nakrimpováním spojek kabel ˚u. To zároveˇn znamenalo, že jsem musel vytvoˇrit nové konektory. Mnou zvolená deska, BTT SKR mini E3 v3.0, má konektory typu XH2.54. S vytváˇrením konektor ˚u jsem mˇel problém, i pˇrestože jsem využil krimpovací kleštˇe, které jsou pro tento úˇcel urˇcený. Problémem bylo, že konektory jsou velmi malé. Konektor ˇcasto na kabelu držel špatnˇe a pˇri zapojování do základní desky se kabel ulomil nebo nebylo spojení mezi konektorem a vodiˇcem.
Pˇri zprovoznˇení softwaru jsem zprvu mˇel problém, protože s tímto procesem nemám zkušenosti. Po nalezení vhodného návodu na portálu Youtube.com, jsem byl schopen dokonˇcit nastavení. U nové tiskárny je nutné vytvoˇrit konfiguraˇcní soubor pro Firmware Klipper. Základ konfiguraˇcního souboru má v repozitáˇri na GitHubu výrobce základní desky. Konfiguraˇcní soubor pro tuto tiskárnu je pˇriložený v mém repozitáˇri. Je ale nutné ho pˇred použitím projít, jestli je správnˇe nastavený pro konkrétní stavbu tiskárny. Hlavnˇe je nutné správnˇe nastavit hodnotu driver_SGTHRS u každého krokového motoru zvlášt’. Jde o sílu, jakou m ˚uže motor vyvinout v ˚uˇci pˇrekážce, než ji zaznamená. toto je d ˚uležitá funkce, pˇredevším pro sensorless homing. Pokud by byla hodnota pˇríliš nízká, tiskárna by náraz nedetekovala a mohlo by dojít k poškození. Pˇri pˇríliš vysoké hodnotˇe, je dostateˇcným odporem i ten, který je vytváˇren pˇri jakémkoliv pohybu tiskárny. Tiskárna by tedy zaˇcátek osy detekovala okamžitˇe, nehledˇe na skuteˇcné pozici. Druhou d ˚uležitou hodnotou, kterou je nutné nastavit, je PID kalibrace vyhˇrívání hotendu a heatbedu. Jde o informaci pro tiskárnu, jak se vyhˇrívání chová a jakou má setrvaˇcnost. Pokud by totiž tiskárna vyhˇrívala až do chvíle dosažení požadované teploty, termistor by sice vˇedˇel, že již bylo dosaženo požadované teploty, ale výhˇrevné tˇelísko by mˇelo pˇríliš vysokou teplotu. Ke stejnému jevu by docházelo i pˇri chladnutí, pro dosažení správné teploty. Proto je tˇreba, aby se topné tˇelísko odpojilo chvíli pˇred dosažením cílové teploty. Kalibrace probˇehne sama, po zadání pˇríkazu:

### PID_CALIBRATE HEATER=<HEATBED/EXTRUDER> TARGET=<POŽADOVANÁ TEPLOTA> a

hodnota je poté uložena pˇríkazem: SAVE_CONFIG.

# 5. Testování

Tiskárna má za sebou 46h 20m tisku. Bˇehem 136 tisk ˚u spotˇrebovala pˇres 200m filamentu. Nutno ˇríct, že vˇetšina tisk ˚u byly kalibraˇcní a pˇred koncem jsem je zastavil, protože se projevila chyba nebo jsem byl již schopen z tisku vyˇcíst, co musím upravit v nastavení tiskárny. Pˇred ˇrádným zkalibrováním tiskárny, se pˇri každém tisku stávalo, že se v pr ˚ubˇehu tisku posunula vrstva, tudíž vrstvy na sebe nenavazovaly. Ukázalo se, že to je kv ˚uli pˇríliš vysokému toku filamentu z trysky, který tvoˇrí pˇrekážku, do které když tryska narazí, zasekne se na chvíli. Druhým d ˚uvodem bylo pˇríliš nízké napˇetí krokových motor ˚u.
D ˚ukladná kalibrace celé tiskárny je podstatným úkonem, který by nemˇel být uspˇechán. Pˇri nastavování jsem postupoval dle návodu na webové stránce ellis3dp.com. Zde je kvalitnˇe zpracovaný postup pro kompletní kalibraci celé tiskárny, vˇcetnˇe návaznosti jednotlivých krok ˚u a dokumentace, jak vypadá správnˇe a špatnˇe nastavený daný aspekt kalibrace. Kompletní kalibrace mi zabrala celý den a šlo o opravdu d ˚ukladnou kompletní kalibraci.
FDM 3D tiskárna bez kalibrace nikdy nebude fungovat tak, jak by mˇela, proto by kalibrace mˇela být úkon, který udˇelá každý nový majitel tiskárny.
V pr ˚ubˇehu testování se vybraný extruder ukázal být dobrou volbou, protože funguje tak, jak jsem oˇcekával. Bˇehem oprav hotendu se ukázalo, že je zde i další nemalá výhoda zvoleného extruderu. Celní ˇcást tiskové hlavy drží na ˇctyˇrech šroubech. Po jejich uvolnˇení je možné vyjmout celý modul ˇ hotendu. Samotný hotend je možné vyjmout po uvolnˇení dalších dvou šroub ˚u. Oproti mé dosavadní tiskárnˇe, Prusa i3 MK2.5S, je to výhoda, protože zde pro zásah do hotendu je nutné demontovat nejdˇríve celý extruder a ten postupnˇe rozebrat, dle návodu. Pˇri jakýchkoliv servisních zásazích je

### nutné být opatrný, aby nedošlo k poškození kabel ˚u nebo jiných komponent ˚u!

# 5.1 Komplikace pˇri testování

Od zaˇcátku používání této tiskárny jsem musel vymˇenit axiální ventilátor hotendu, protože byl pˇríliš hluˇcný. Druhým d ˚uvodem bylo, že pˇri opravˇe tiskárny jsem ho poškodil tak, že se ulomila jedna z lopatek. Ventilátor byl poté pˇríliš hluˇcný, kv ˚uli vzniklým vibracím, které vznikly kv ˚uli vzniklému nevyváženému stavu. Dalším nutným zásahem bylo pˇripájení kabel ˚u radiálního ventilátoru, protože se mi bohužel ulomily v místˇe pˇripojení na ventilátor.
Problémem, který jsem musel dvakrát ˇrešit, je ucpání heatbreaku. Pˇri prvním pravdˇepodobnˇe šlo o ucpání, kv ˚uli nesprávné manipulaci s tiskárnou z mojí strany, pˇri vyjímání filamentu. V druhém pˇrípadˇe jsem nezjistil, proˇc došlo k chybˇe a jestli nešlo napˇríklad o vadu filamentu. Jde o jev, který je nutné do budoucna pozorovat, protože se m ˚uže dít pˇri nekvalitním titanovém heatbreaku. I pˇres skuteˇcnost, že jsem koupil kvalitní, m ˚uže jít o nepovedený kus.
V souˇcasné dobˇe na tiskárnˇe pozoruji lehké prohýbání tiskové podložky pˇri zvýšeném tlaku od trysky, pˇredevším pˇri špatném tisku. Jde o následek toho, že heatbed je uchycen pouze z jedné strany. Negativní vliv na výtisky zatím nepozoruji.

# 6. Možné vylepšení tiskárny

Tiskárna je ve plnˇe funkˇcním stavu, ale jsou zde funkce a možnosti, které tiskárna zatím nemá implementovány, ale je možné je vytvoˇrit. I po ukonˇcení maturitního projektu bych rád do stejného repozitáˇre pˇridával pˇrípadné zmˇeny na tiskárnˇe, aby kdokoliv, kdo by se rozhodl stavˇet tuto tiskárnu, mˇel nejnovˇejší verzi.

### - Kompletní ochrana elektroniky

Bohužel jsem již kv ˚uli nedostatku ˇcasu nestihl implementovat ochranu elektroniky ze zadní ˇcásti tiskárny. Mˇelo by jít o plexisklo, umístˇené na pantech na rámu tiskárny. v zavˇreném stavu budou tyto dvíˇrka držet pomocí magnet ˚u. P ˚ujde o plexisklo s tloušt’kou 2mm a mám ho již zakoupené.

### - Konektor pro zapojení ethernetu

V souˇcasné dobˇe musí být kabel ethernetu provleˇcen skrz boˇcní mˇrížku, aby mohl být zapojen do RPi. Lepším ˇrešením by bylo, udˇelat ethernetovou spojku nˇekde v oblasti rámu, napˇríklad vedle zásuvky napájení. Do této spojky by byl pˇriveden ethernetový kabel vedoucí z RPi. Opˇet jde o úpravu, kterou jsem bohužel nestihl.

### - Madla pro pˇrenos tiskárny

Tiskárnu je možné pˇri pˇrenášení držet za nosný rám. Pokud by ale nˇekdo preferoval napˇríklad plastová madla, není problém je pˇripevnit kamkoliv na rám, pomocí odpovídajících šroub ˚u a kamen ˚u.

### - Displej pro ovládání tiskárny

Tiskárnu je možné ovládat pomocí rozhraní Mainsail. Pokud by ale nˇekdo preferoval fyzický displej na tiskárnˇe, je možnost jeho dodateˇcné implementace.

### - Zakrytí tiskové plochy

Pro tisk z nároˇcnˇejších materiál ˚u se doporuˇcuje uzavˇrít tiskovou oblast, aby teplo zde vytvoˇrené neunikalo do okolí. Tato ztráta teploty m ˚uže napˇríklad u ABS zp ˚usobovat rozlomení modelu pˇri jeho chladnutí. Na druhou stranu zakrytování není vhodné pro tisk z PLA, protože ventilátory nefungují tak úˇcinnˇe, protože mají k dispozici vzduch teplejší, než bez zakrytování.

### - Integrované schránky pro pˇríslušenství k tiskárnˇe

K provozování tiskárny je ˇcasto nutné i náˇradí. V rámu je dostatek prostoru okolo tiskové plochy, aby zde byly pˇridány schránky, ve kterých by bylo umístˇeno pˇríslušenství k tiskárnˇe. Pˇríslušenstvím je myšleno nejenom náˇradí, potˇrebné k práci na tiskárnˇe, ale napˇríklad také r ˚uzné náhradní trysky.

### - Zprovoznˇení LED diod na extruderu - Zprovoznˇení indukˇcního senzoru mesh bed levelling

# 7. Závˇer

Práce na tomto projektu byla ˇcasovˇe velmi nároˇcná. Nejenom z hlediska samotného navrhování tisku. V první fázi, ve které jsem zhodnotil vˇetšinu dostupných technologií, byla nároˇcná na výzkum, pˇredevším protože jsem se snažil informace ˇcerpat ze zkušeností jiných uživatel ˚u, a ne každý má stejné zkušenosti s výrobky. Z toho d ˚uvodu bylo nároˇcné vytvoˇrit si ucelený pˇrehled o problematice. Druhá fáze samotného návrhu byla opˇet ˇcasovˇe nároˇcná, protože každá navrhovaná souˇcástka je pomˇernˇe komplexní souˇcást. A špatnˇe vytvoˇrený model by mohl vyústit v nekvalitnˇe pracující tiskárnu. Proto jsem si dával záležet, aby zkonstruované prvky byly co nejvíce kvalitní. Tˇretí fází bylo samotné sestavení tiskárny. Nejnároˇcnˇejší ˇcástí zde bylo vytvoˇrení nových konektor ˚u XH2.54, z d ˚uvodu popsaného ve kapitole o stavbˇe tiskárny. Psaní této práce jsem se rozhodl pojmout velmi zeširoka, aby i ˇclovˇek jen se základními znalostmi, po pˇreˇctení této práce získal stejné znalosti, které jsem získal bˇehem pr ˚uzkumu. Bohužel jsem již nestihl zkonstruovat nˇekteré prvky, jako napˇríklad schránky pro pˇríslušenství. Celkovˇe je zde stále prostor pro vylepšení, která mohu na tiskárnˇe provádˇet. Pˇredem stanovené požadavky se mi podaˇrilo splnit všechny, kromˇe kompaktní velikosti. Tiskárna je vˇetší, než jsem p ˚uvodnˇe zamýšlel. Je to dáno kombinací jednotlivých vybraných komponent ˚u. Na druhou stranu více prostoru mi dává prostor pro další funkce, které mohu zakomponovat. S výsledkem této práce jsem spokojený. Tiskárna samotná tiskne kvalitnˇe, pˇri zachování pˇekné kvality. Zároveˇn veškeré ovládací prvky tiskárny mi vyhovují a i dostupnost souˇcástek pˇri provádˇení oprav považuji za dobrou.

# Internetové zdroje

[] http://user.mendelu.cz/marik/in-mat-web/in-mat-webse21.html.
[] http://user.mendelu.cz/marik/in-mat-web/in-mat-webse21.html.
[] http://www.realisticky.cz/ucebnice/01%20Matematika%20S%C5%A0/07%20Analytick%C3%A1%20geometrie/01%20Sou%C5%99adnice/01%20Kart%C3%A9zsk%C3%A9%20soustavy%20sou%C5%99adn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. [] https://3dinsider.com/choosing-firmware-3d-printer/.
[] https://3dprintingspace.com/t/8-bit-vs-32-bit-control-boards-whats-the-advantage/1082.
[] https://all3dp.com/2/3d-printer-firmware-which-to-choose-and-how-to-change-it/.
[] https://all3dp.com/2/3d-printer-nozzle-size-material-what-to-know-which-to-buy/.
[] https://all3dp.com/2/best-stepper-motor-driver/.
[] https://all3dp.com/2/cartesian-3d-printer-delta-scara-belt-corexy-polar/.
[] https://all3dp.com/2/klipper-pid-tune-tuning-3d-printer/.
[] https://all3dp.com/2/klipper-vs-marlin-difference/.
[] https://all3dp.com/2/linear-rail-3d-printer-really-better-or-just-a-hype/. [] https://cs.wikipedia.org/wiki/Makro_(software).
[] https://dyzedesign.com/2019/04/differences-12v-24v-3d-printer/.
[] https://eshop.sharplayers.cz/p/bi-metal-heatbreak-kratsi.
[] https://eshop.sharplayers.cz/p/btt-skr-mini-e3-v3-zakladni-deska-pro-3d-tiskarny.
[] https://github.com/jschuh/klipper-macros.
[] https://marlinfw.org/docs/basics/introduction.html.
[] https://printingit3d.com/8-bit-vs-32-bit-control-board-in-3d-printing-which-is-better/.
[] https://reprap.org/wiki/List_of_FirmwareMarlin.
[] https://sj.news/svetovy-lidr-vsadil-vsechno-na-svou-novou-produktovou-radu-hot-endu-k-3d-tiskarnamporusuji-nas-patent-tvrdi-cesky-startup-a-mobilizuje-pravniky/.
[] https://the3dprinterbee.com/corexy-vs-hbot/.
[] https://www.3dsourced.com/3d-printers/types-of-fdm-3d-printer-cartesian-delta/.
[] https://www.captubes.com/safety.html.
[] https://www.drdflo.com/pages/Guides/How-to-Build-a-3D-Printer/Motherboard.html. [] https://www.gadgetreview.com/8-bit-vs-32-bit-3d-printer.
[] https://www.kywoo3d.com/blogs/3d-printer-news/v-slot-wheels-vs-linear-rails.
[] https://www.motioncontroltips.com/faq-what-are-stepper-drives-and-how-do-they-work/. [] https://www.prusa3d.com/cs/produkt/original-prusa-xl-2/.
[] https://www.surpluscenter.com/images/techhelp/nema2.pdf.
[] https://www.zikodrive.com/ufaqs/nema-motor-frame-sizes-mean/.
