AdamSedla/CoreXY-3D-printer/Hardware/VoriPrinter-bill_of_material.pdf

Material | Quantity
2020 500mm | 4
2020 400mm | 6
2020 350mm | 9
2020 330mm | 2
2020 300mm | 2
2020 280mm | 1
2020 140mm | 3
M3 2020 nut | 20
M5 2020 stone | 24
M3 2020 stone | 66
M6 2020 stone | 4
M3 nut | 4
M5 security nut | 10
M3 washer | 9
M4 washer | 4
M3X6 countersunk head | 3
M3X6 hemispherical head | 67
M3X6 cylindrical head | 9
M3X8 cylindrical head | 66
M3X10 cylindrical head | 18
M3X12 cylindrical head | 8
M3X16 cylindrical head | 2
M3X20 cylindrical head | 1
M3X25 cylindrical head | 6
M3X30 cylindrical head | 3
M3X40 countersunk head | 4
M3X50 cylindrical head | 2
M4X6 hemispherical head | 4
M5X10 hemispherical head | 32
M5X12 hemispherical head | 2
M5X30 cylindrical head | 2
M5X40 cylindrical head | 8
M6X5 hemispherical head | 4
M6X16 cylindrical head | 6
M6X20 hemispherical head | 40
Thread insert 3x4x5 | 42
Rubber anti-vibration feet | 4
Heatbed springs | 4
Belt pulley | 14
MGN12H 250mm | 5
Belt motor pulley | 2
Belt 1,7m | 2

Trapezoid screw | 1
Trapezoid clutch | 1
Trapezoid nut | 1
17HS8401S | 3
MeanWell LRS-350-24 | 1
RaspBerry Pi 4B | 1
BTT SKR mini E3 v3 | 1
Power socket | 1
Power cable | 1
Heatbed | 1
Magnetic pad for Heatbed | 1
Energy chain 7X7 40cm | 1
Energy chain 10X10 40cm | 2
Energy chain ending 7X7 female | 1
Energy chain ending 7X7 male | 1
Energy chain ending 10X10 female | 2
Energy chain ending 10X10 male | 2
Cable for motors | 3
Wire | 80
XH2.54 connectors set | 1
Step down converter. 24V to 5V | 1
LDO-36STH20 | 1
5015 radial fan 24v | 1
4010 axial fan24v | 1
Neopixel WS2812B | 3
Heat insert 24v 40w | 1
Termistor NTC100k | 1
Autolevelling sensor (SN04-N) | 1
BMG extruder kit | 1
V6 Titan heatbreak | 1
V6 heatblock | 1
V6 heatsink | 1
