AdamSedla/CoreXY-3D-printer/Hardware/VoriPrinter-parts_for_print.pdf

3D_model | Quantity
BTT_SKR_mini_E3_v3_support | 1
RPi_support | 1
power_socket_support | 1
heatbed_calibration_screw | 4
heatbed_energy_chain | 1
heatbed_front | 1
heatbed_rear_left | 1
heatbed_rear_right | 1
trapezoid_nut_support | 1
front_mesh_bottom_edge | 2
front_mesh_bottom_middle | 1
front_mesh_middle_edge | 2
front_mesh_middle_middle | 1
front_mesh_top_edge | 2
front_mesh_top_middle | 1
side_mesh_small | 1
side_mesh | 3
base_legs | 4
filament_holder_L | 1
filament_holder_P | 1
tensioner_L | 1
tensioner_P | 1
tensioner_nut | 2
tensioner_screw | 2
XY_motor_support_L | 1
XY_motor_support_P | 1
Y_axis_support_L | 1
Y_axis_support_P | 1
energy_chain_support | 1
Z_axis_motor_support | 1
Z_axis_upper_end_stop | 2
Z_axis_down_end_stop | 2
