AdamSedla/CoreXY-3D-printer/Hardware/3D_models/3mf/Electronic/BTT_SKR_mini_E3_v3_support.3mf

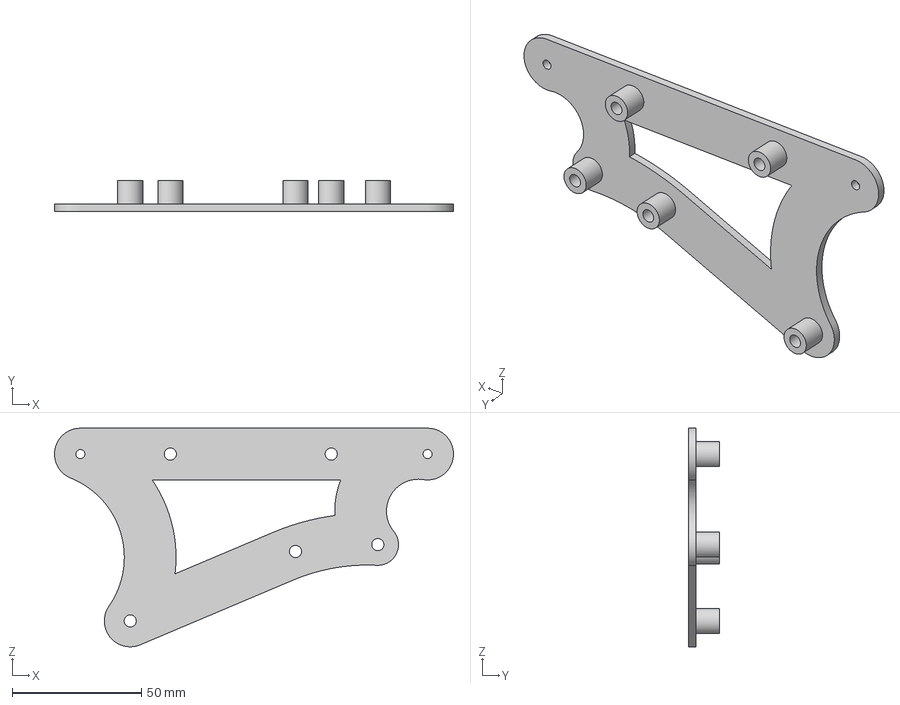
[picture p2: CAD file, 2023-03-20]
Hardware/3D_models/3mf/Electronic/BTT_SKR_mini_E3_v3_support.3mf
154.1 x 12.0 x 84.5 mm
