AdamSedla/CoreXY-3D-printer/Hardware/3D_models/3mf/Heatbed/heatbed_rear_left.3mf

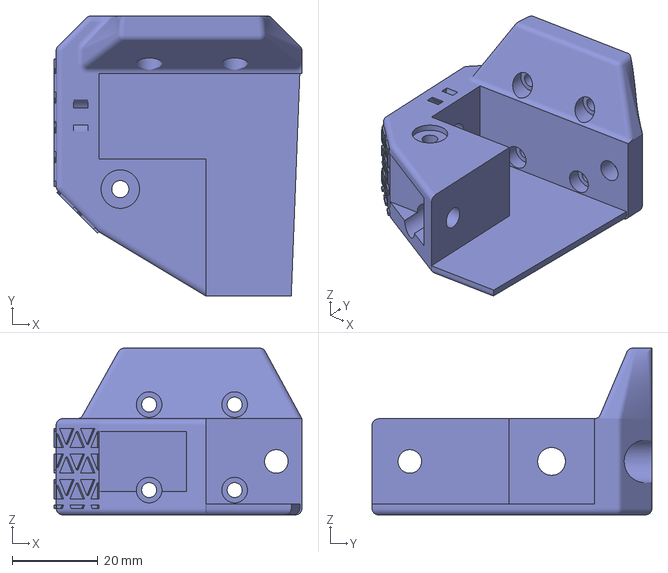
[picture p3: CAD file, 2023-03-20]
Hardware/3D_models/3mf/Heatbed/heatbed_rear_left.3mf
58.0 x 65.5 x 39.0 mm
