AdamSedla/CoreXY-3D-printer/Hardware/3D_models/3mf/Other/filament_holder_L.3mf

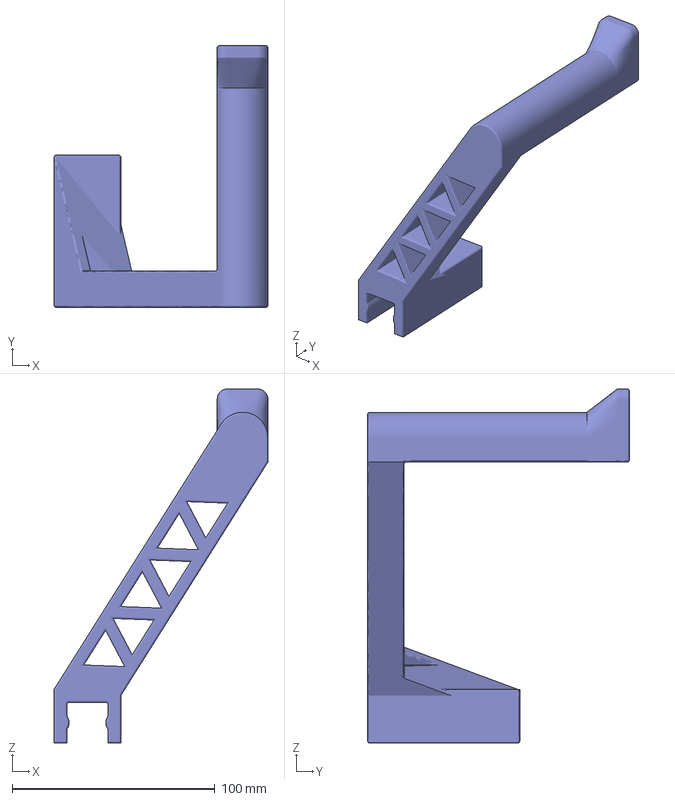
[picture p5: CAD file, 2023-03-20]
Hardware/3D_models/3mf/Other/filament_holder_L.3mf
105.4 x 129.0 x 174.5 mm
