AdamSedla/CoreXY-3D-printer/Hardware/3D_models/3mf/XY_axis/XY_motor_support_L.3mf

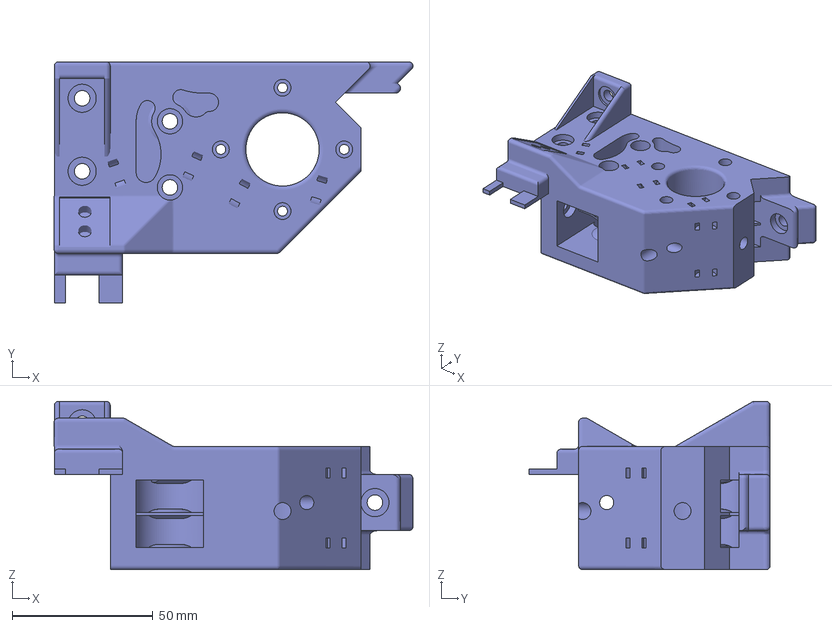
[picture p6: CAD file, 2023-03-20]
Hardware/3D_models/3mf/XY_axis/XY_motor_support_L.3mf
127.6 x 85.8 x 59.9 mm
