AdamSedla/CoreXY-3D-printer/Hardware/3D_models/3mf/Electronic/power_socket_support.3mf

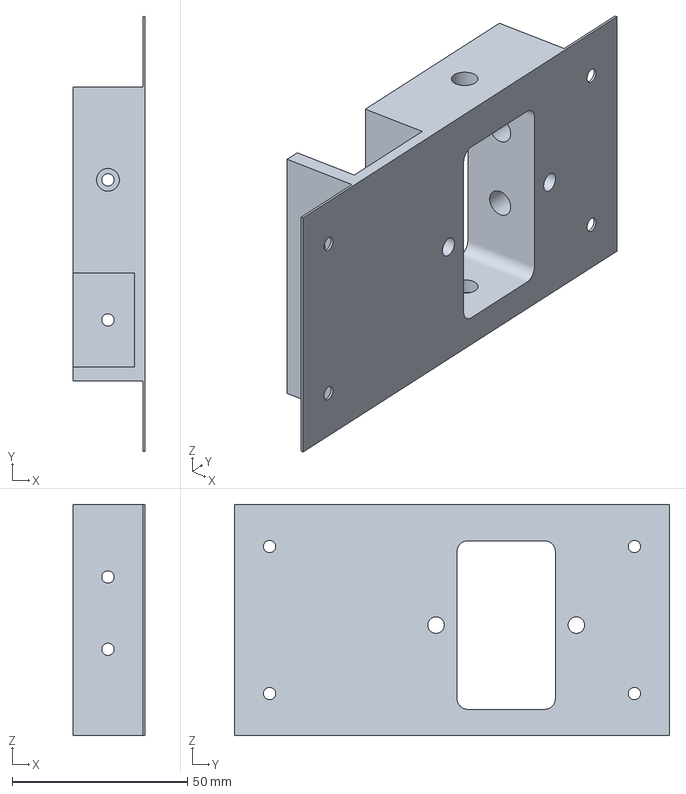
[picture p8: CAD file, 2023-03-20]
Hardware/3D_models/3mf/Electronic/power_socket_support.3mf
20.6 x 124.0 x 65.9 mm
