AdamSedla/CoreXY-3D-printer/Hardware/3D_models/3mf/Mesh/front_mesh_top_edge.3mf

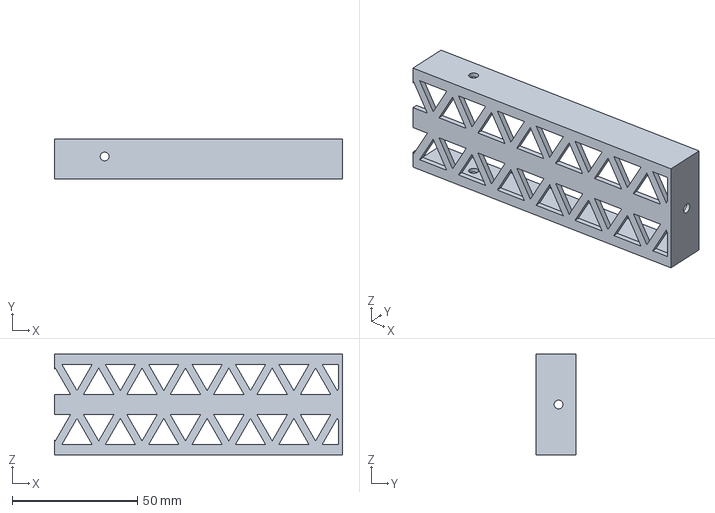
[picture p9: CAD file, 2023-03-20]
Hardware/3D_models/3mf/Mesh/front_mesh_top_edge.3mf
115.0 x 16.0 x 40.2 mm
