AdamSedla/CoreXY-3D-printer/Hardware/3D_models/3mf/Other/base_legs.3mf

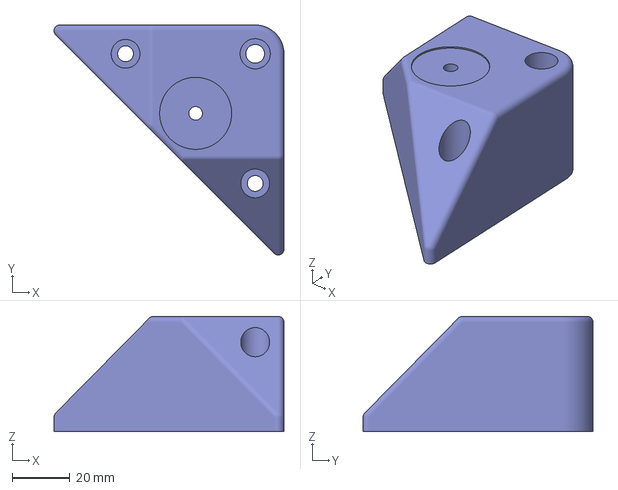
[picture p10: CAD file, 2023-03-20]
Hardware/3D_models/3mf/Other/base_legs.3mf
79.8 x 79.8 x 40.0 mm
