AdamSedla/CoreXY-3D-printer/Hardware/3D_models/3mf/Z_axis/Z_axis_upper_end_stop.3mf

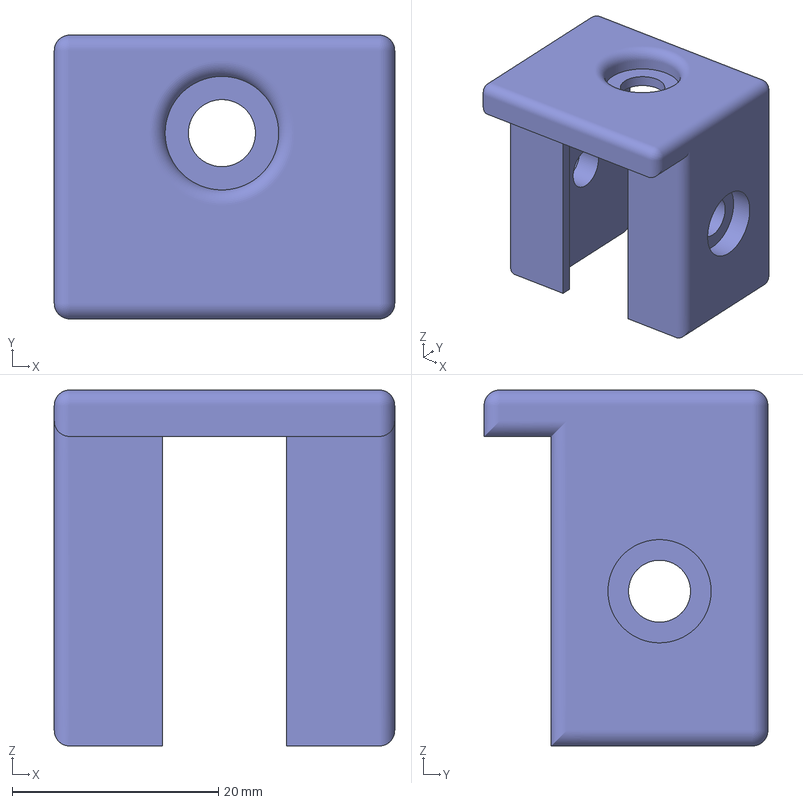
[picture p11: CAD file, 2023-03-20]
Hardware/3D_models/3mf/Z_axis/Z_axis_upper_end_stop.3mf
33.0 x 27.5 x 34.5 mm
