AdamSedla/CoreXY-3D-printer/Hardware/3D_models/3mf/Electronic/RPi_support.3mf

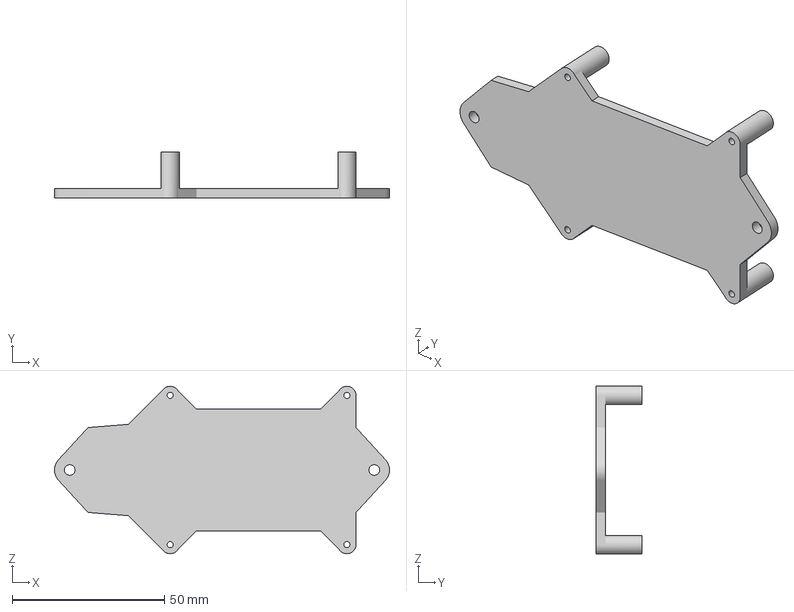
[picture p12: CAD file, 2023-03-20]
Hardware/3D_models/3mf/Electronic/RPi_support.3mf
110.0 x 15.0 x 55.0 mm
