AdamSedla/CoreXY-3D-printer/Hardware/3D_models/3mf/Mesh/front_mesh_bottom_edge.3mf

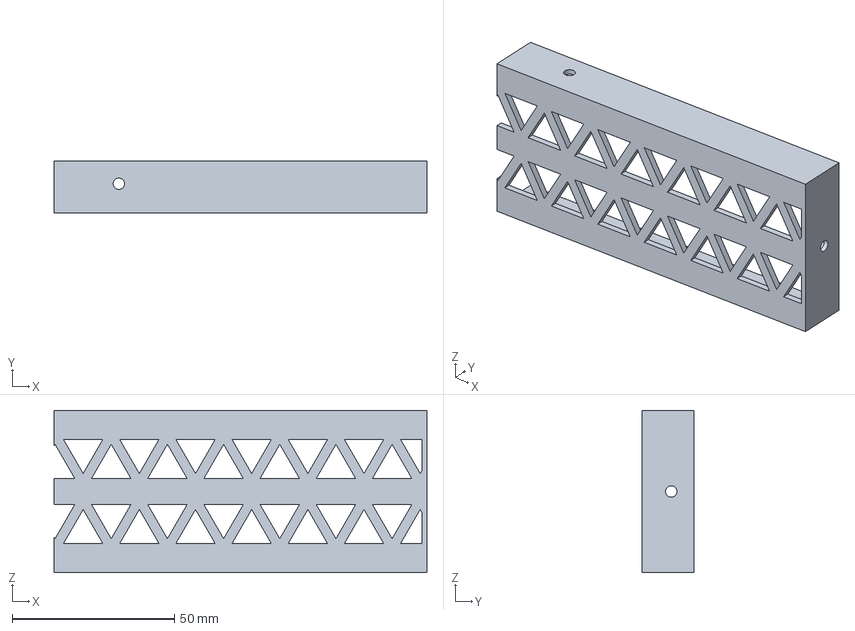
[picture p13: CAD file, 2023-03-20]
Hardware/3D_models/3mf/Mesh/front_mesh_bottom_edge.3mf
115.0 x 16.0 x 50.0 mm
