AdamSedla/CoreXY-3D-printer/Hardware/3D_models/3mf/XY_axis/tensioner_P.3mf

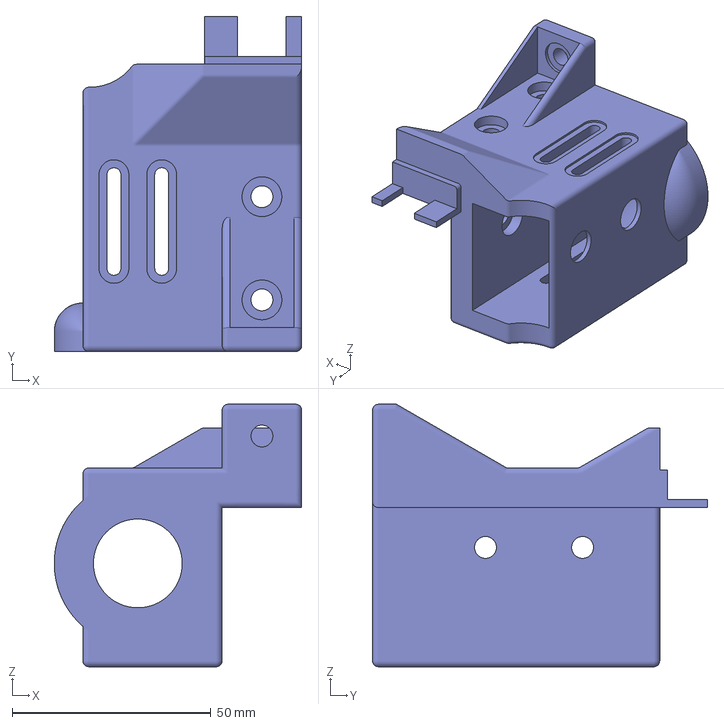
[picture p14: CAD file, 2023-03-20]
Hardware/3D_models/3mf/XY_axis/tensioner_P.3mf
62.2 x 84.2 x 66.0 mm
