AdamSedla/CoreXY-3D-printer/Hardware/3D_models/3mf/Z_axis/Z_axis_motor_support.3mf

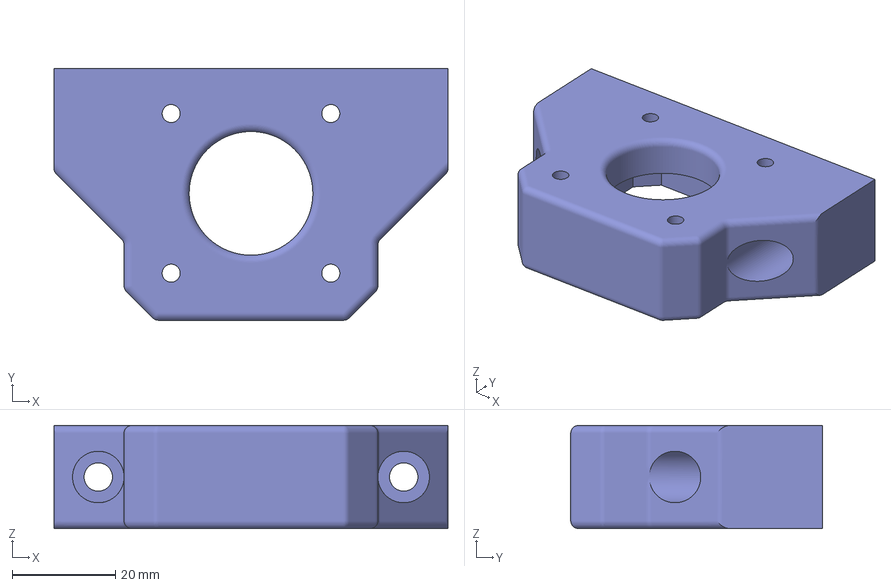
[picture p15: CAD file, 2023-03-20]
Hardware/3D_models/3mf/Z_axis/Z_axis_motor_support.3mf
76.5 x 48.9 x 20.0 mm
