AdamSedla/CoreXY-3D-printer/Hardware/3D_models/3mf/Z_axis/energy_chain_support.3mf

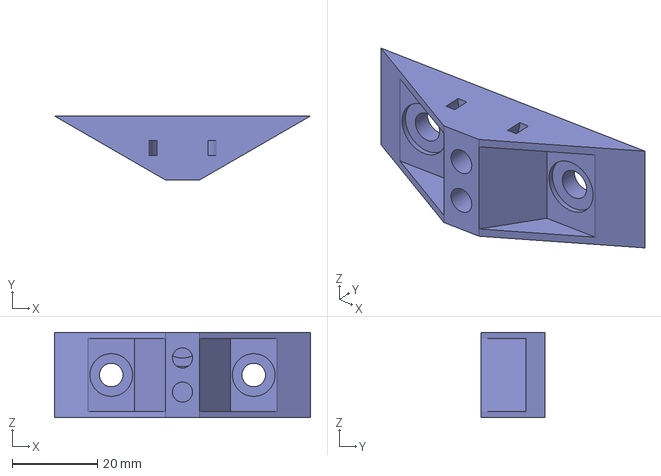
[picture p17: CAD file, 2023-03-20]
Hardware/3D_models/3mf/Z_axis/energy_chain_support.3mf
60.0 x 15.0 x 20.0 mm
