AdamSedla/CoreXY-3D-printer/Hardware/3D_models/3mf/Heatbed/heatbed_front.3mf

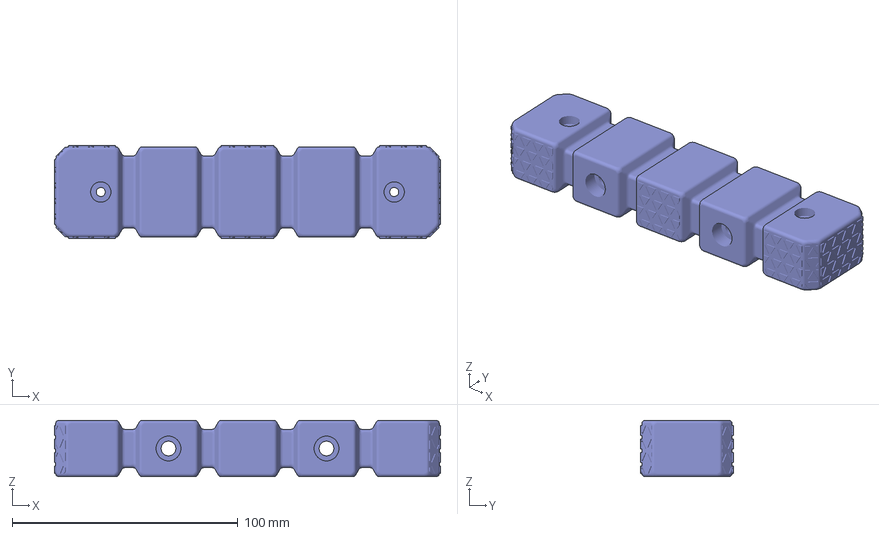
[picture p18: CAD file, 2023-03-20]
Hardware/3D_models/3mf/Heatbed/heatbed_front.3mf
171.0 x 41.0 x 25.0 mm
