AdamSedla/CoreXY-3D-printer/Hardware/3D_models/3mf/XY_axis/Y_axis_support_P.3mf

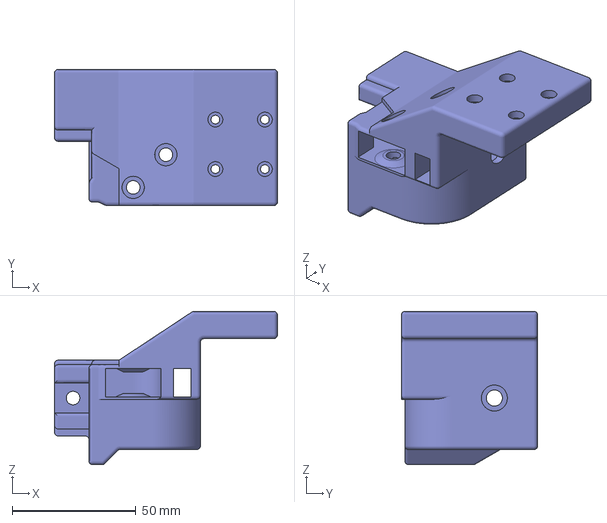
[picture p20: CAD file, 2023-03-20]
Hardware/3D_models/3mf/XY_axis/Y_axis_support_P.3mf
90.1 x 55.1 x 61.9 mm
