AdamSedla/CoreXY-3D-printer/Hardware/3D_models/3mf/Heatbed/heatbed_energy_chain.3mf

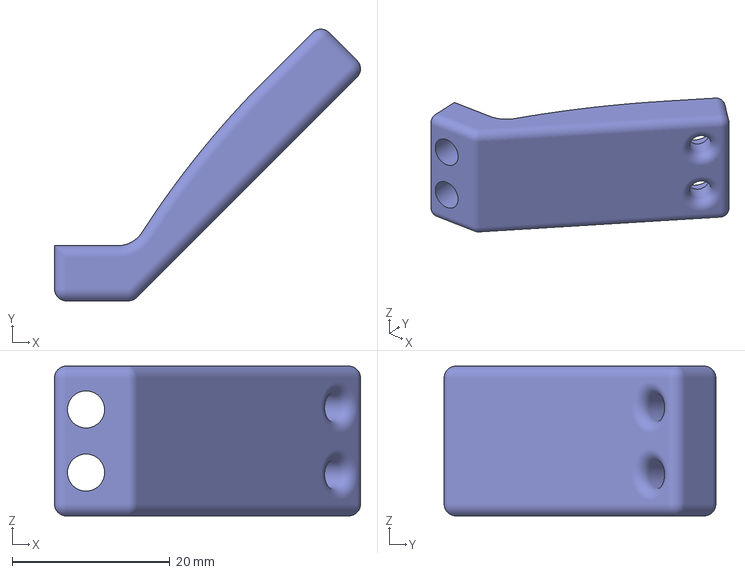
[picture p21: CAD file, 2023-03-20]
Hardware/3D_models/3mf/Heatbed/heatbed_energy_chain.3mf
38.8 x 34.4 x 19.0 mm
