AdamSedla/CoreXY-3D-printer/Hardware/3D_models/3mf/Mesh/side_mesh.3mf

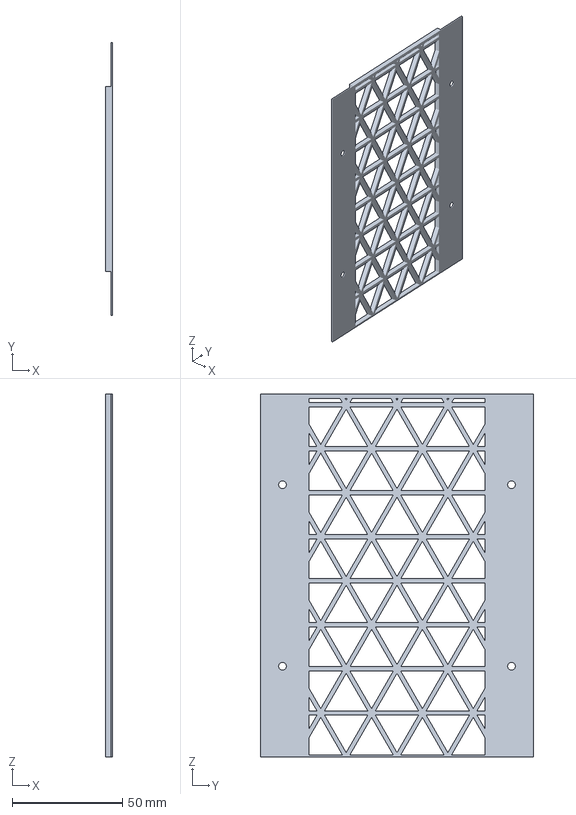
[picture p23: CAD file, 2023-03-20]
Hardware/3D_models/3mf/Mesh/side_mesh.3mf
3.00 x 124.0 x 164.9 mm
