AdamSedla/CoreXY-3D-printer/(list of files, cad)

Other CAD files:
Hardware/3D_models/3mf/Heatbed/heatbed_rear_right.3mf
Hardware/3D_models/3mf/Other/filament_holder_P.3mf
Hardware/3D_models/3mf/XY_axis/tensioner_L.3mf
Hardware/3D_models/3mf/XY_axis/XY_motor_support_P.3mf
Hardware/3D_models/3mf/Heatbed/heatbed_calibration_screw.3mf
Hardware/3D_models/3mf/Heatbed/trapezoid_nut_support.3mf
Hardware/3D_models/3mf/XY_axis/tensioner_nut.3mf
Hardware/3D_models/3mf/XY_axis/tensioner_screw.3mf
Hardware/3D_models/stl/Electronic/BTT_SKR_mini_E3_v3_support.stl
Hardware/3D_models/stl/Electronic/RPi_support.stl
Hardware/3D_models/stl/Electronic/power_socket_support.stl
Hardware/3D_models/stl/Heatbed/heatbed_calibration_screw.stl
Hardware/3D_models/stl/Heatbed/heatbed_energy_chain.stl
Hardware/3D_models/stl/Heatbed/heatbed_rear_left.stl
Hardware/3D_models/stl/Heatbed/heatbed_rear_right.stl
Hardware/3D_models/stl/Heatbed/trapezoid_nut_support.stl
Hardware/3D_models/stl/Mesh/front_mesh_bottom_edge.stl
Hardware/3D_models/stl/Mesh/front_mesh_bottom_middle.stl
Hardware/3D_models/stl/Mesh/front_mesh_middle_edge.stl
Hardware/3D_models/stl/Mesh/front_mesh_middle_middle.stl
Hardware/3D_models/stl/Mesh/front_mesh_top_edge.stl
Hardware/3D_models/stl/Mesh/front_mesh_top_middle.stl
Hardware/3D_models/stl/Mesh/side_mesh.stl
Hardware/3D_models/stl/Mesh/side_mesh_small.stl
Hardware/3D_models/stl/Other/base_legs.stl
Hardware/3D_models/stl/Other/filament_holder_L.stl
Hardware/3D_models/stl/Other/filament_holder_P.stl
Hardware/3D_models/stl/XY_axis/XY_motor_support_L.stl
Hardware/3D_models/stl/XY_axis/XY_motor_support_P.stl
Hardware/3D_models/stl/XY_axis/Y_axis_support_L.stl
Hardware/3D_models/stl/XY_axis/Y_axis_support_P.stl
Hardware/3D_models/stl/XY_axis/tensioner_L.stl
Hardware/3D_models/stl/XY_axis/tensioner_P.stl
Hardware/3D_models/stl/XY_axis/tensioner_nut.stl
Hardware/3D_models/stl/XY_axis/tensioner_screw.stl
Hardware/3D_models/stl/Z_axis/Z_axis_down_end_stop.stl
Hardware/3D_models/stl/Z_axis/Z_axis_motor_support.stl
Hardware/3D_models/stl/Z_axis/Z_axis_upper_end_stop.stl
Hardware/3D_models/stl/Z_axis/energy_chain_support.stl
