AdamSedla/CoreXY-3D-printer/VoriPrinter_build_instructions.pdf

# VoriPrinter building instruction

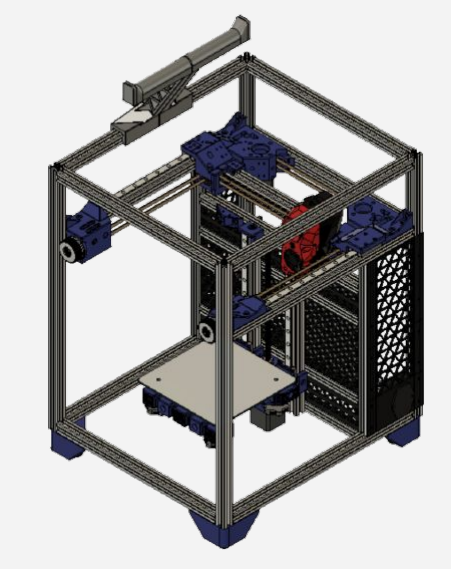
[picture p26: figure]

# Before building

- Carefully study the instructions before building
- In case of any confusion, study the 3D model of the printer
- Read the complete list of materials needed
- this is only an approximate quantity
- The printer should be built by an experienced user
- Risk of injury or death
- Tools needed for the build:
- Drill for aluminium 6mm
- M6 tapping tool
- Allen set
- Soldering kit
■ Soldering iron
■ Solder
■ rosin

# Structure

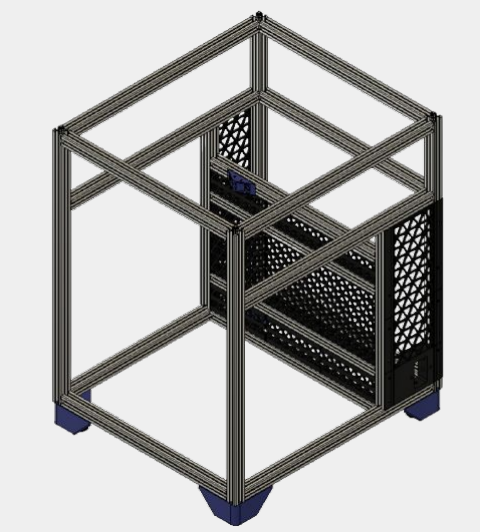
[picture p27: figure]

# Before building structure

- Prepare 2020 profiles:
- Use an M6 tap to create a thread in all 2020 profiles
■ The thread may remain unused in some places
- Use a 6mm drill bit to make holes at the connection point
- The profiles are connected as follows:
- Screw the M6X20 screw into the profile, the end of which will be perpendicular to the other profile
■ Do not tighten the screw!
- Insert the bolt and the profile into the groove of the second profile
- Place the profile in the correct position
- Tighten the bolt through the hole in the second profile
- This does not apply to 300mm profiles for the Z-axis
■ These profiles are fixed with M6 slot stones
- Review the placement of components on the frame before building
- Insert the stones to place these components into the profile before assembling the frame
■ Otherwise they cannot be inserted without disassembling the frame
■ This does not apply when using nuts in profiles

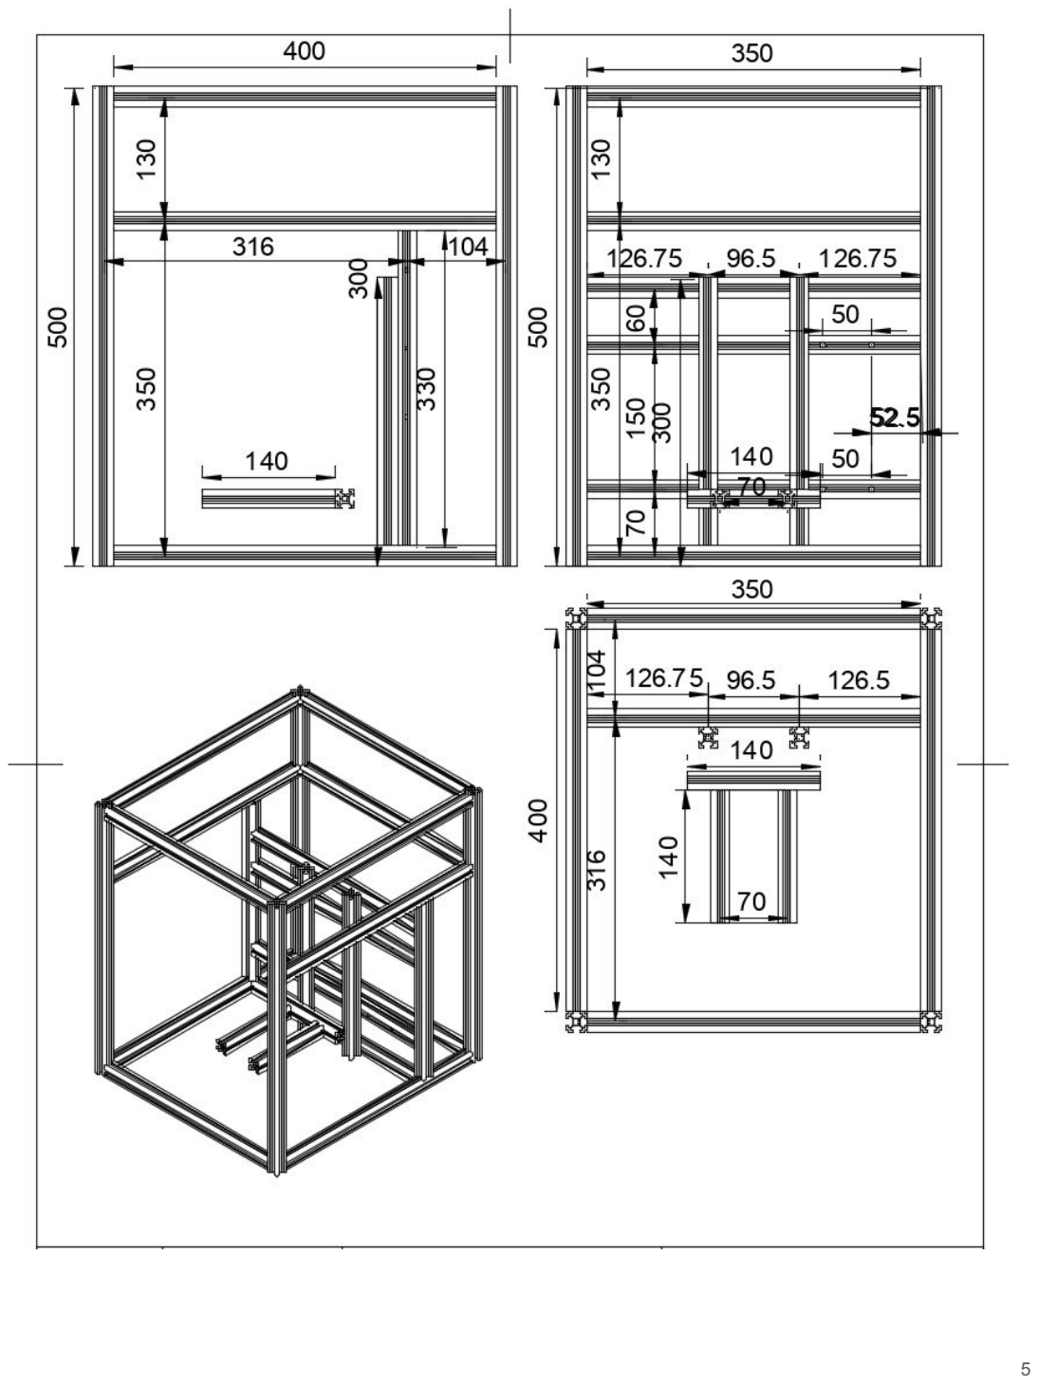
[picture p28: page 5]

# Recommended building method

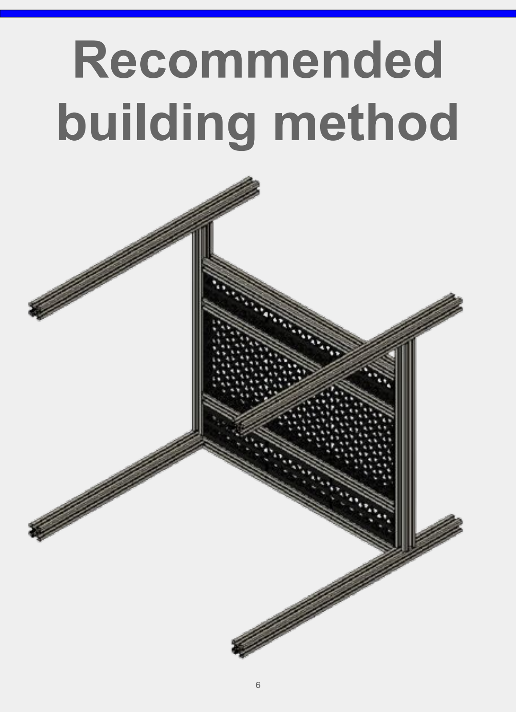
[picture p29: page 6]

# Recommended building method

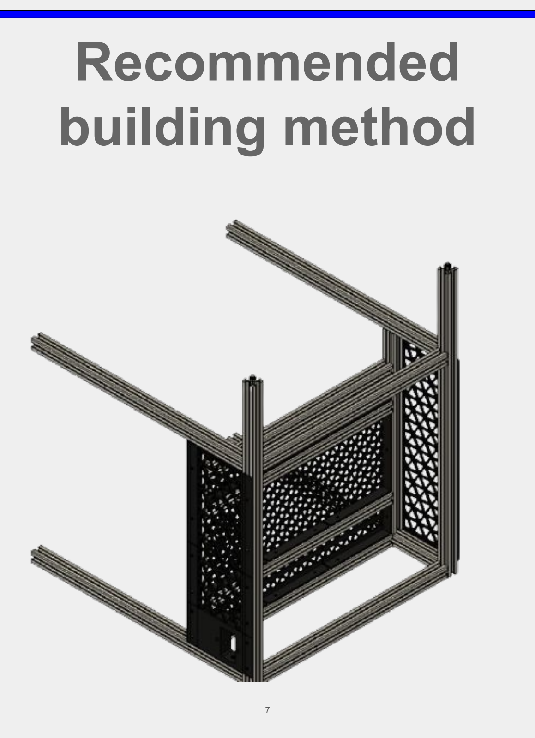
[picture p30: page 7]

# Recommended building method

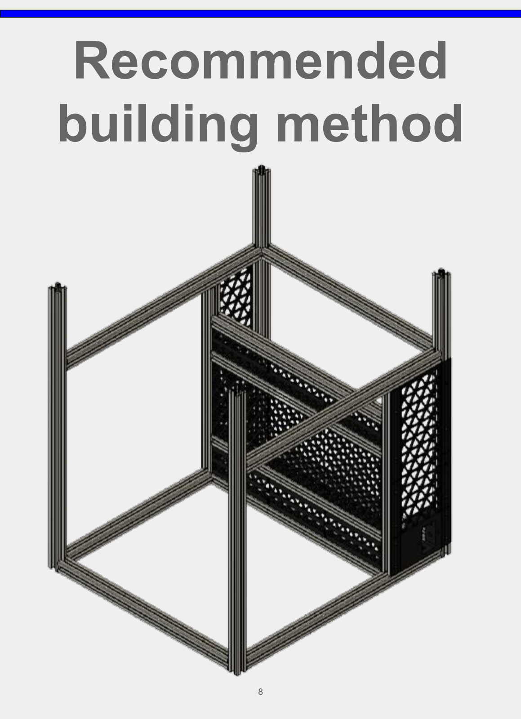
[picture p31: page 8]

# Recommended building method

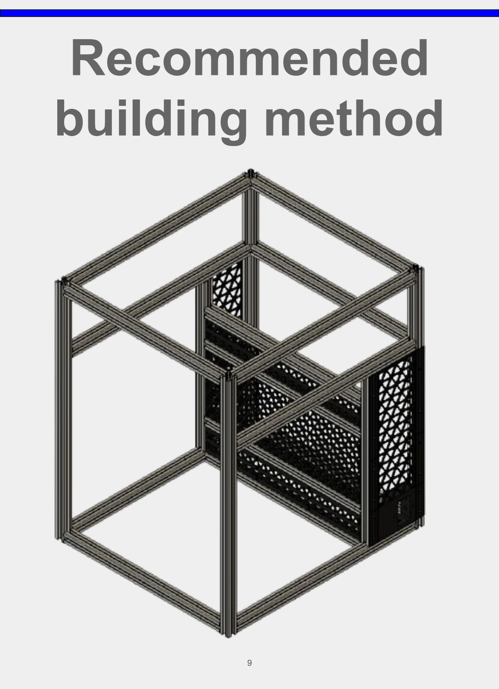
[picture p32: page 9]

# Recommended building method

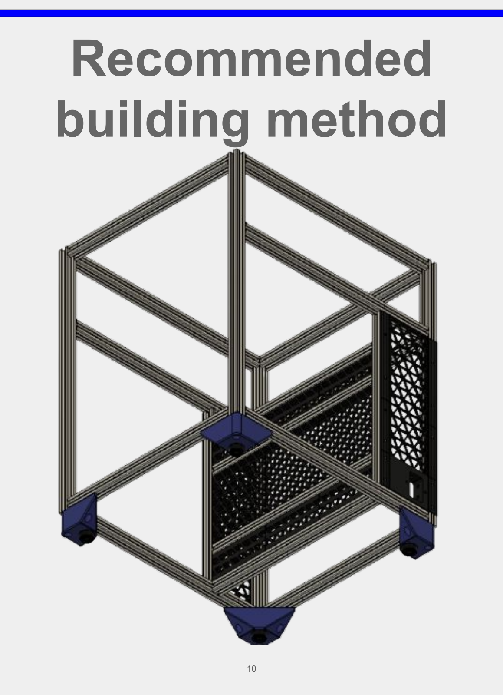
[picture p33: page 10]

# Recommended building method

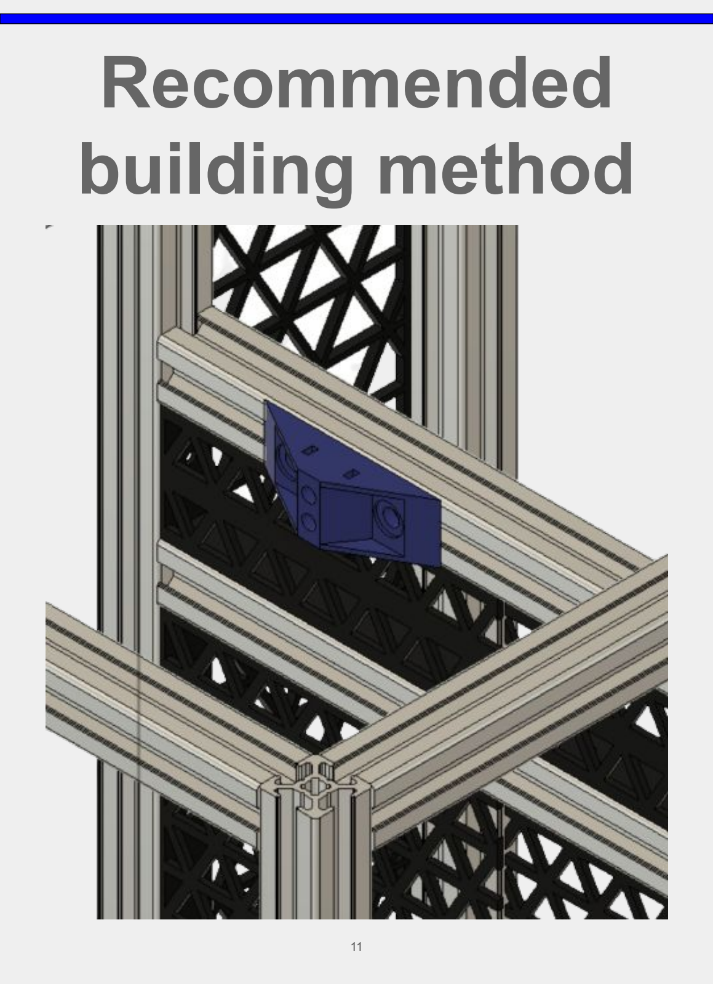
[picture p34: page 11]

# Y axis

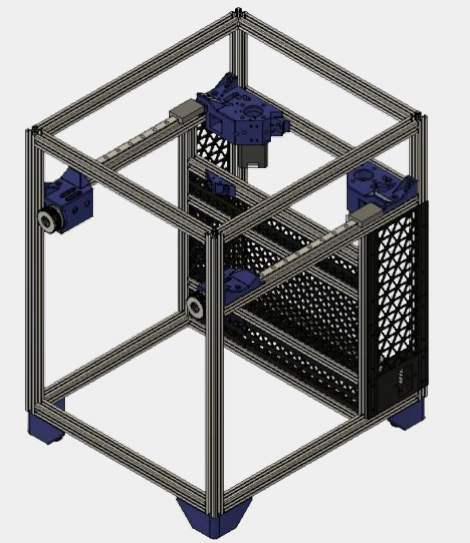
[picture p35: figure]

# Y axis

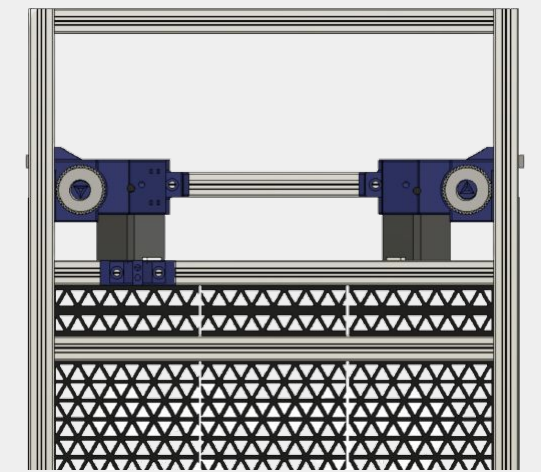
[picture p36: figure]

# Y axis

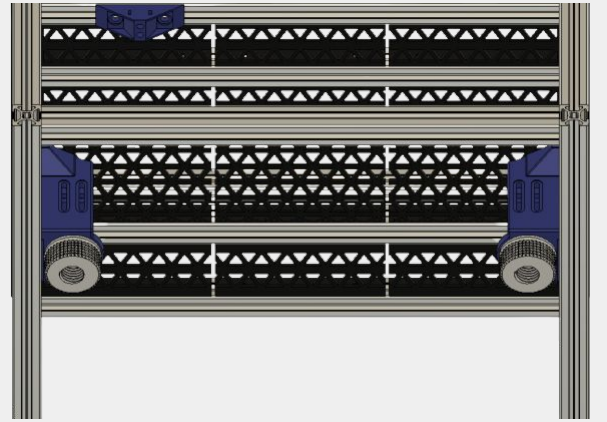
[picture p37: figure]

# Y axis

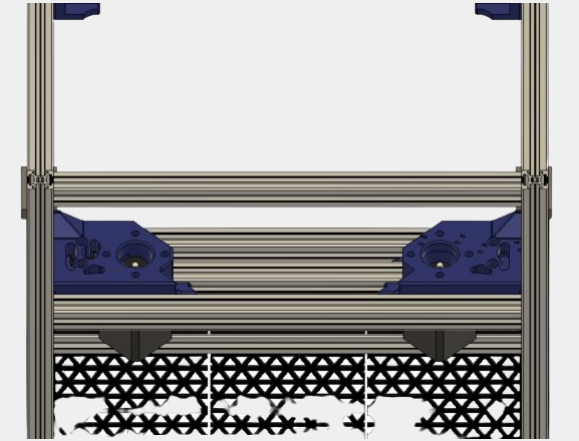
[picture p38: figure]

# X axis

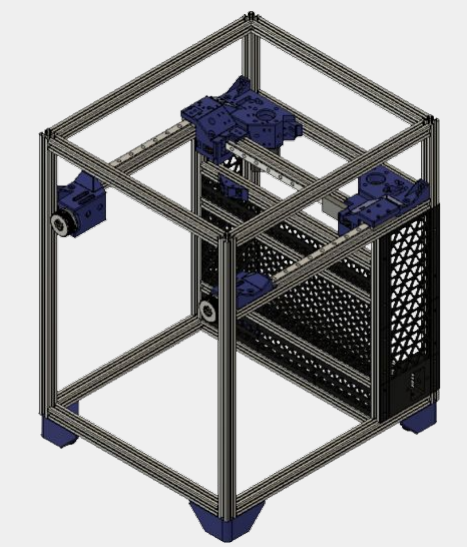
[picture p39: figure]

# X axis

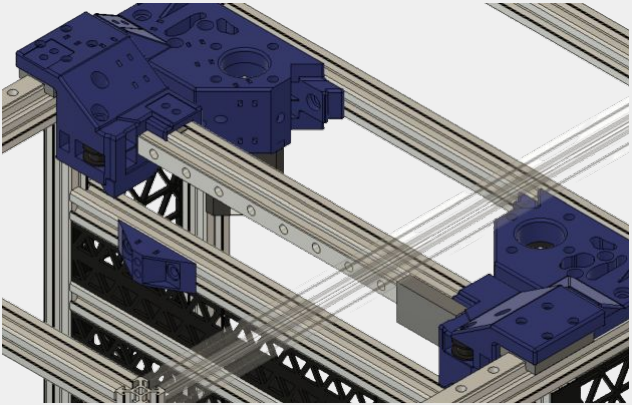
[picture p40: figure]

# X axis

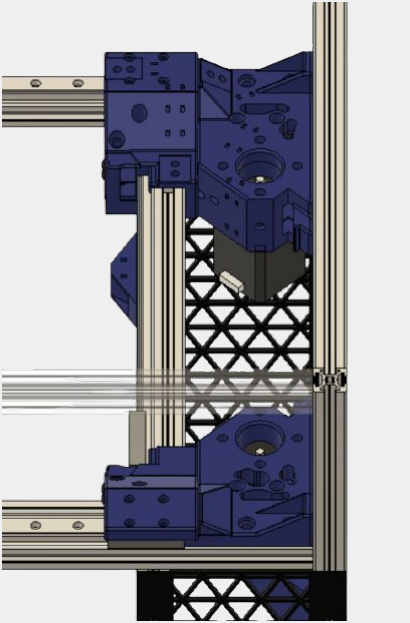
[picture p41: figure]

# X axis

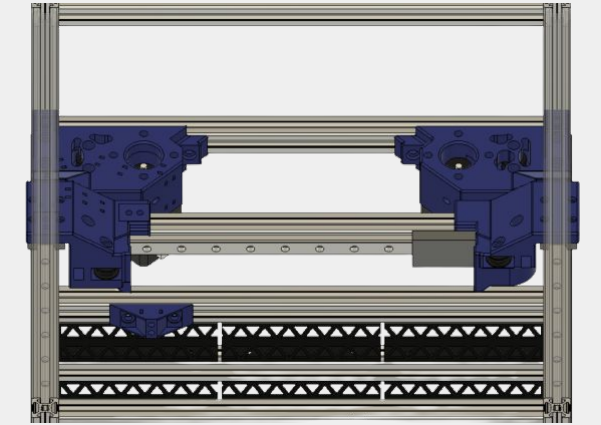
[picture p42: figure]

# Extruder

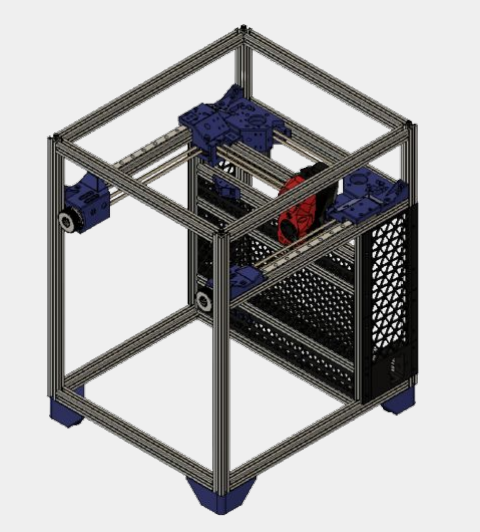
[picture p43: figure]

# Extruder

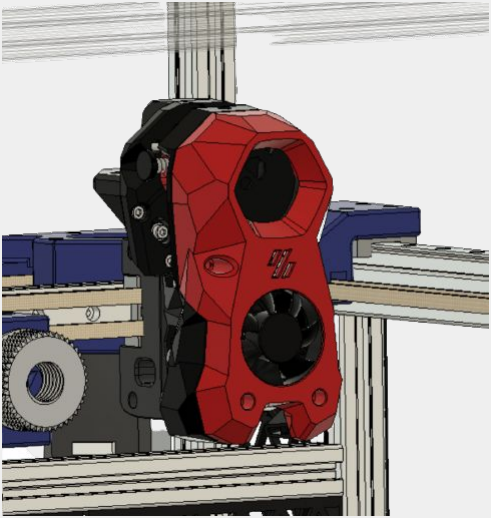
[picture p44: figure]

# Extruder

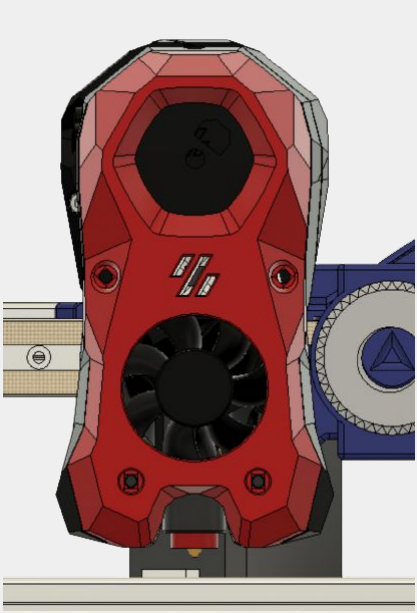
[picture p45: figure]

# Extruder

## - Build the Extruder according to the instructions of

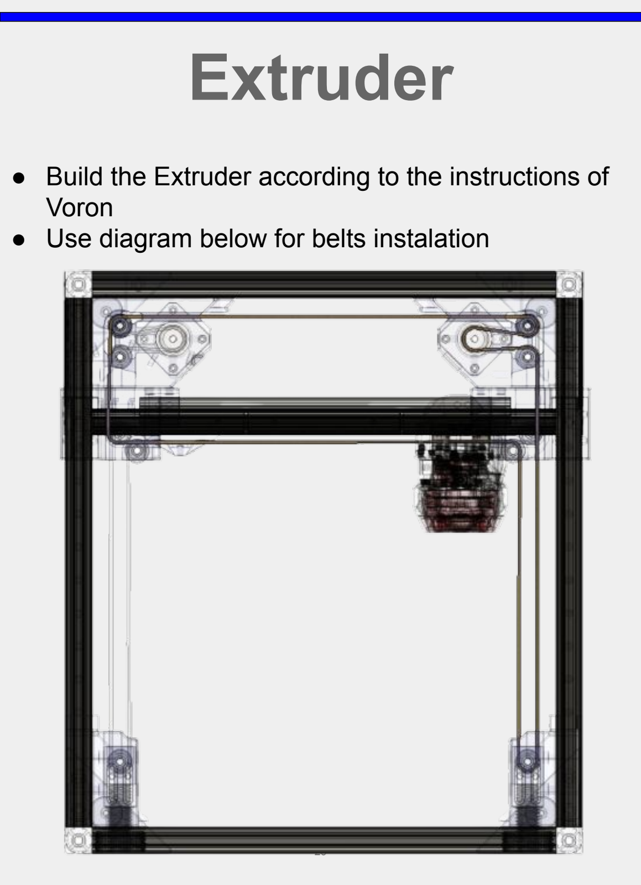
[picture p46: page 23]

## Voron - Use diagram below for belts instalation

# Extruder

## - Upper belt

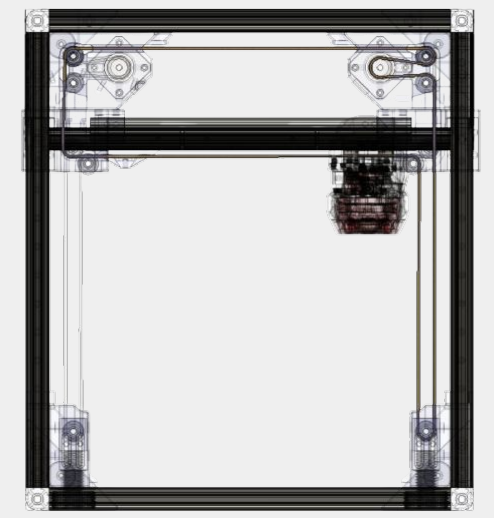
[picture p47: figure]

# Extruder

## - Lower belt

●

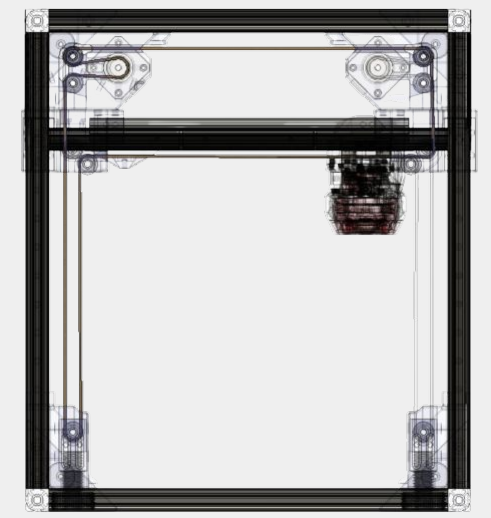
[picture p48: figure]

# Z axis

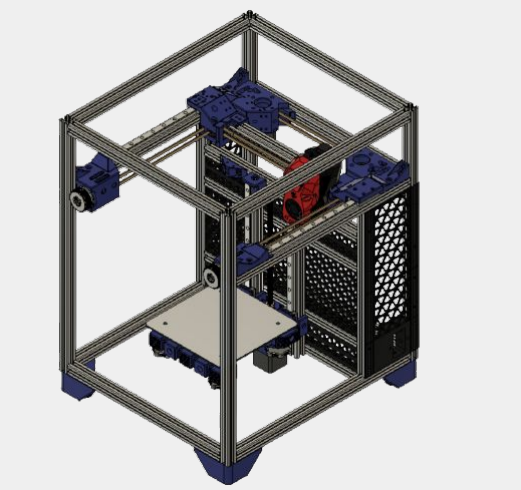
[picture p49: figure]

# Z axis

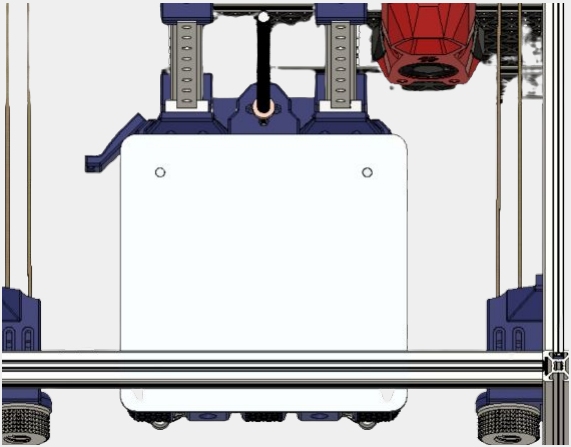
[picture p50: figure]

# Z axis

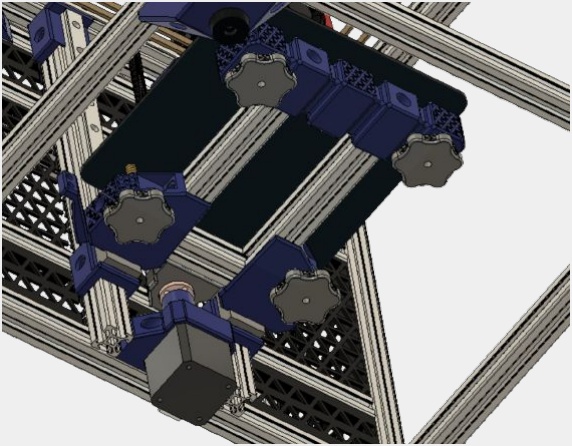
[picture p51: figure]

# Z axis

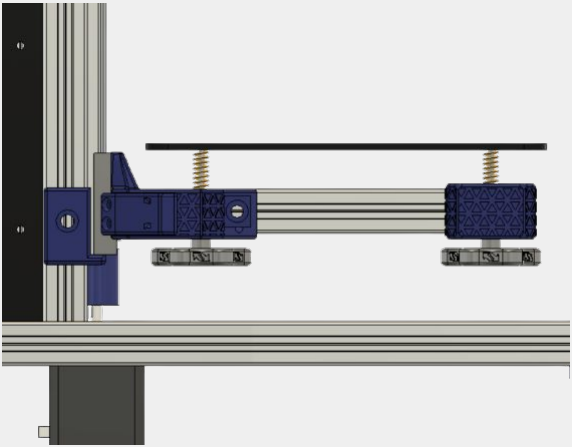
[picture p52: figure]

# Z axis

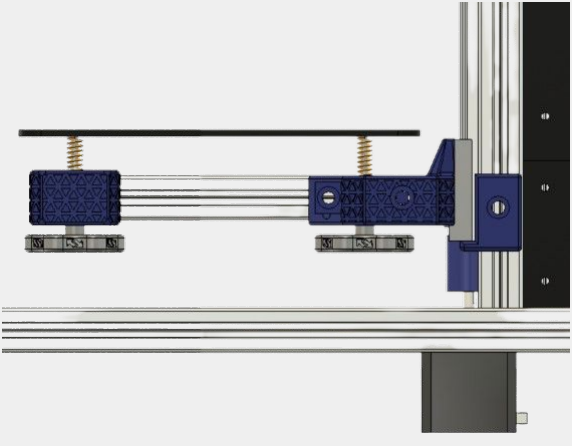
[picture p53: figure]

# Electronics

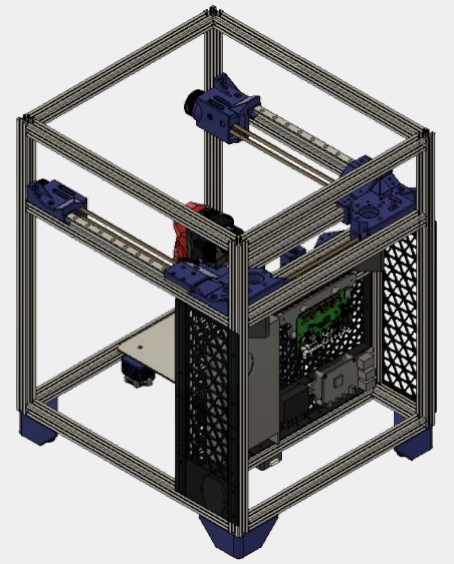
[picture p54: figure]

# Electronics

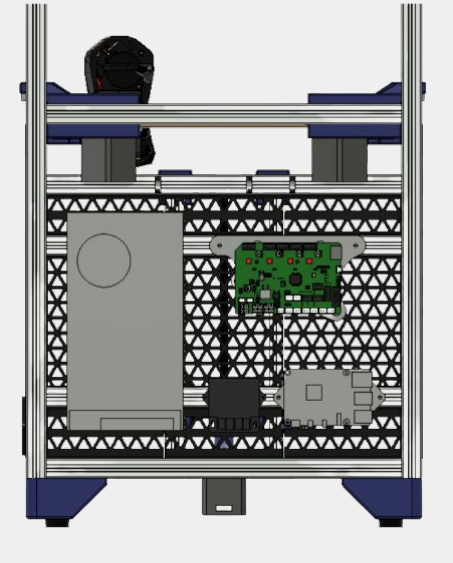
[picture p55: figure]

# Electronics

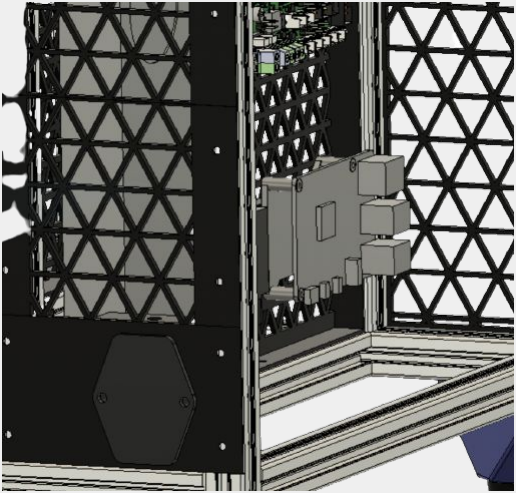
[picture p56: figure]

# Electronics

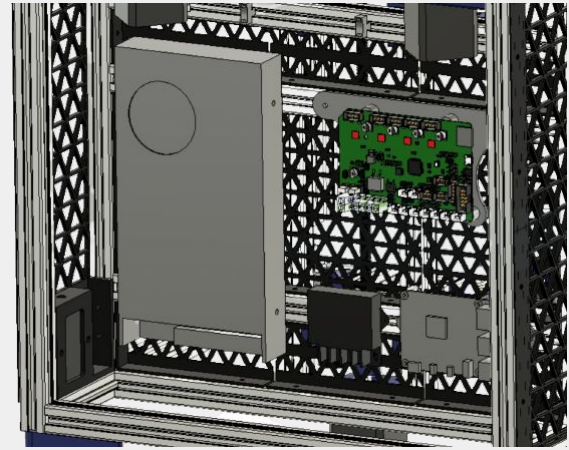
[picture p57: figure]

## - Wire the electronics according to the manual for your components - Electronic components should only be installed by a qualified person - Risk of serious injury or death! - Before connecting to the mains, thoroughly check all electronics and their wiring

# Electronics

# Filament holder

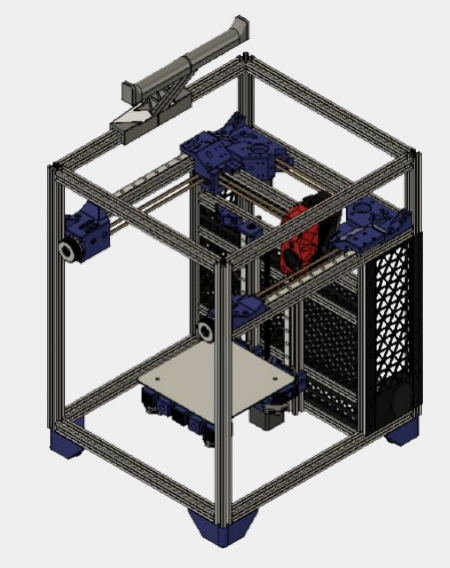
[picture p58: figure]

# Software

## - Printer is ready to be used with Klipper - When using another software, check if RaspBerry Pi is needed - Run the software according to its instructions
