AdamSedla/CoreXY-3D-printer/Software/Mainsail_config/printer.cfg

# This file contains common pin mappings for the BIGTREETECH SKR mini
# E3 v3.0. To use this config, the firmware should be compiled for the
# STM32G0B1 with a "8KiB bootloader" and USB communication.

# The "make flash" command does not work on the SKR mini E3. Instead,
# after running "make", copy the generated "out/klipper.bin" file to a
# file named "firmware.bin" on an SD card and then restart the SKR
# mini E3 with that SD card.

# See docs/Config_Reference.md for a description of parameters.

[include mainsail.cfg]

[stepper_x]
step_pin: PB13
dir_pin: PB12
enable_pin: !PB14
microsteps: 16
rotation_distance: 40
endstop_pin: tmc2209_stepper_x:virtual_endstop
homing_retract_dist: 0
position_min: -12
position_endstop: -12
position_max: 180
homing_speed: 60

[tmc2209 stepper_x]
diag_pin: ^PC0 # use the same pin that was previously the endstop_pin!
driver_SGTHRS: 100
uart_pin: PC11
tx_pin: PC10
uart_address: 0
run_current: 1.05
stealthchop_threshold: 999999

[stepper_y]
step_pin: PB10
dir_pin: PB2
enable_pin: !PB11
microsteps: 16
rotation_distance: 40
endstop_pin: tmc2209_stepper_y:virtual_endstop
homing_retract_dist: 0
position_min: -12
position_endstop: -12
position_max: 180
homing_speed: 60

[tmc2209 stepper_y]
diag_pin: ^PC1     # use the same pin that was previously the endstop_pin!
driver_SGTHRS: 100 # 255 is most sensitive value, 0 is least sensitive
uart_pin: PC11
tx_pin: PC10
uart_address: 2
run_current: 1.05
stealthchop_threshold: 999999

[stepper_z]
step_pin: PB0
dir_pin: !PC5
enable_pin: !PB1
microsteps: 16
rotation_distance: 8
endstop_pin: tmc2209_stepper_z:virtual_endstop
homing_retract_dist: 0
#position_endstop: 0.0
position_max: 190
position_min: -0.1
homing_speed: 60

[tmc2209 stepper_z]
diag_pin: ^PC2     # use the same pin that was previously the endstop_pin!
driver_SGTHRS: 50 # 255 is most sensitive value, 0 is least sensitive
uart_pin: PC11
tx_pin: PC10
uart_address: 1
run_current: 0.2
stealthchop_threshold: 999999

[extruder]
step_pin: PB3
dir_pin: PB4
enable_pin: !PD1
microsteps: 16
rotation_distance: 4.54
nozzle_diameter: 0.400
filament_diameter: 1.750
heater_pin: PC8
sensor_type: EPCOS 100K B57560G104F
sensor_pin: PA0
#control: pid
#pid_Kp: 21.527
#pid_Ki: 1.063
#pid_Kd: 108.982
min_temp: 0
max_temp: 280
max_extrude_only_distance: 151
pressure_advance: 0.06

[tmc2209 extruder]
uart_pin: PC11
tx_pin: PC10
uart_address: 3
run_current: 0.800
stealthchop_threshold: 0

[heater_bed]
heater_pin: PC9
sensor_type: ATC Semitec 104GT-2
sensor_pin: PC4
control: pid
pid_Kp: 54.027
pid_Ki: 0.770
pid_Kd: 948.182
min_temp: 0
max_temp: 130

[heater_fan heatbreak_cooling_fan]
pin: PC7

[heater_fan controller_fan]
pin: PB15

[fan]
pin: PC6

[mcu]
serial: /dev/serial/by-id/usb-Klipper_stm32g0b1xx_3D0013001750425938323120-if00

[printer]
kinematics: corexy
max_velocity: 300
max_accel: 3000
max_z_velocity: 5
max_z_accel: 100

[board_pins]
aliases:
    # EXP1 header
    EXP1_1=PB5,  EXP1_3=PA9,   EXP1_5=PA10, EXP1_7=PB8, EXP1_9=<GND>,
    EXP1_2=PA15, EXP1_4=<RST>, EXP1_6=PB9,  EXP1_8=PD6, EXP1_10=<5V>

# See the sample-lcd.cfg file for definitions of common LCD displays.

#*# <---------------------- SAVE_CONFIG ---------------------->
#*# DO NOT EDIT THIS BLOCK OR BELOW. The contents are auto-generated.
#*#
#*# [extruder]
#*# control = pid
#*# pid_kp = 16.940
#*# pid_ki = 0.672
#*# pid_kd = 106.719
#*#
#*# [stepper_z]
#*# position_endstop = 0.000
