AdamSedla/CoreXY-3D-printer/(commit log)

2023-01-04 přidán heatbed, vč. jeho základny
    Do hlavního 3D modelu tiskárny byl implementován heatbed i se základnou. Obojí bude sloužit jako osa Z, svým pohybem nahoru a dolu po lineárních vedeních, která jsou zde také přidána.
2023-01-07 upraveny tolerance, přidány kladky
    Na základě tisku prototypů, upraveny tolerance napínáku řemene (šroub a matice).
    Přidány kladky jako referenční body pro tvorbu uchycení motoru a vedení řemenu
2023-01-11 přidán repozitář extruderu
    Při stavbě bude použit extruder Voron Stealthburner
2023-01-16 přidány kolečka pro levelling, dokončena osa XY
    Dokončen nosník motorů a kompletní vedení řemenů na ose XY. Přidány řemeny pro vizualizaci
    Započato přepracování osy Y. Přidány kolečka pro bed levelling z vlastní produkce, z důvodu nevyhovujících kupovaných.
2023-01-31 přidáno ochranné mřížky, podnožky, zásuvka, osa Z, elektronika
    Přidány přední ochranné mřížky elektroniky, fungující zároveň jako pomůcka pro přesnou montáž profilů v rámu.
    Přidány podstavené antivibrační podnožky.
    Upraveny boční ochranné mřížky elektroniky, vč. přidání uchycení zásuvky.
    Přidán pohon osy Z. Tj. uchycení krokového motoru osy Z a uchycení trapézové matice na tiskovou podložku.
    Přidána elektronika, vč. uchycení
2023-02-28 přidán seznam materiálu
    [VoCube - seznam materiálu.xlsx]
2023-03-09 změna názvu, upraven seznam materiálu
    [TrianglePrinter - seznam materiálu.xlsx]
2023-03-20 opravena chyba chlazení v config
    v config file bylo u PLA filamentu vypnuté chlazení. K vypnutí došlo omylem při testování.
    chlazení je nyní zapnuté u všech přednastavených filamentů
2023-03-20 přidány stl soubory
    přidány jednotlivé .stl tiskove soubory
    [BTT_SKR_mini_E3_v3_uchyceni.stl, Heatbed_2.stl, Heatbed_3.stl, RPi_uchyceni.stl, Z_motor_uchyceni.stl, Zasix_upendstop.stl, Zaxis_downendstop.stl, bocni_mrizka.stl]
2023-03-20 upraveny názvy heatbed uchycení
    [Heatbed_leva_zadni.stl, Heatbed_prava_zadni.stl]
2023-03-20 přesunutý úchyt energetického řetězu
    [energeticky_retez_heatbed.stl]
2023-03-20 přidán soubor uchycení trapéz matice
    [trapez_matice_uchyceni.stl]
2023-03-20 přidány .3mf soubory
    přidány jednotlivé .3mf soubory k tisku
    [BTT_SKR_mini_E3_v3_uchyceni.3mf, Heatbed_leva_zadni.3mf, Heatbed_prava_zadni.3mf, RPi_uchyceni.3mf, Z_motor_uchyceni.3mf, Zasix_upendstop.3mf, Zaxis_downendstop.3mf, bocni_mrizka.3mf]
2023-03-21 přidán printer.cfg
    přidán konfigurační soubor pro systém mainsail
    [printer.cfg]
2023-03-22 přejmenován seznam materiálu
    odstraněna diakritika z názvu dokumentu se seznamem materiálu
    [TrianglePrinter - seznam materialu.xlsx]
2023-03-23 upraveny názvy
    změněn název podstavných noh
    Z: podnozka
    Na: podstavne_nohy
    [podstavne_nohy.3mf, podstavne_nohy.stl]
2023-03-23 přidán seznam dílů k vytisknutí
    přidán seznam dílů, které je potřeba před stavbou vytisknout na 3D tiskárně. Přidán .pdf i .xlsx
    [TrianglePrinter - dily k vytisknuti.xlsx]
2025-07-06 translation EN -> CZ
    [BTT_SKR_mini_E3_v3_support.3mf, BTT_SKR_mini_E3_v3_support.stl, BTT_SKR_mini_E3_v3_uchyceni.3mf, BTT_SKR_mini_E3_v3_uchyceni.stl, Heatbed_leva_zadni.3mf, Heatbed_leva_zadni.stl, Heatbed_prava_zadni.3mf, Heatbed_prava_zadni.stl]
